OpenLabTools/Microscope/Docs/Presentation Images/3D Printing 2.JPG

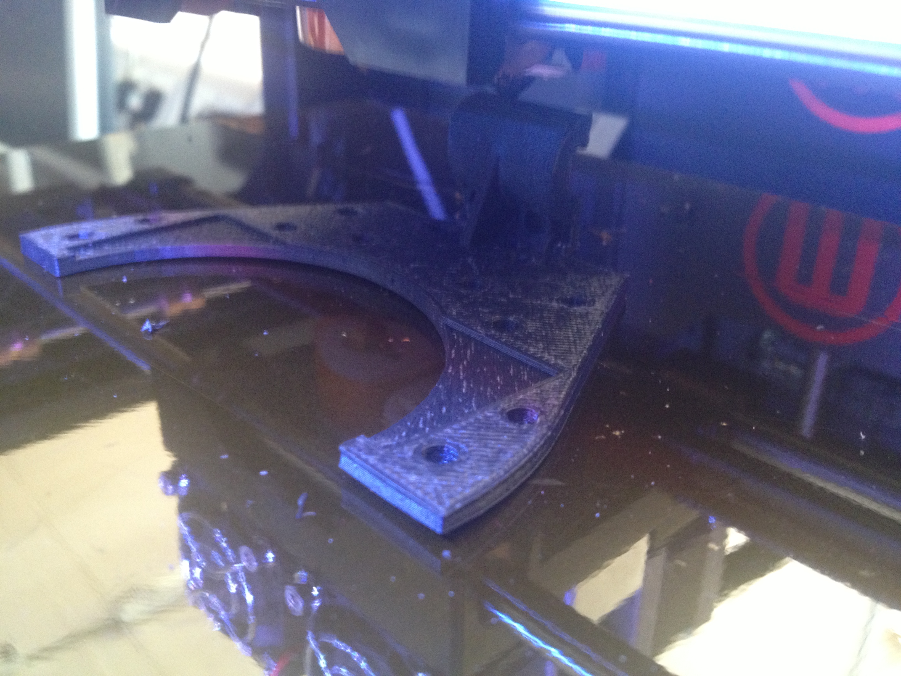
Docs/Presentation Images/3D Printing 2.JPG
