OpenLabTools/Microscope/Docs/Presentation Images/3D Printing 1.JPG

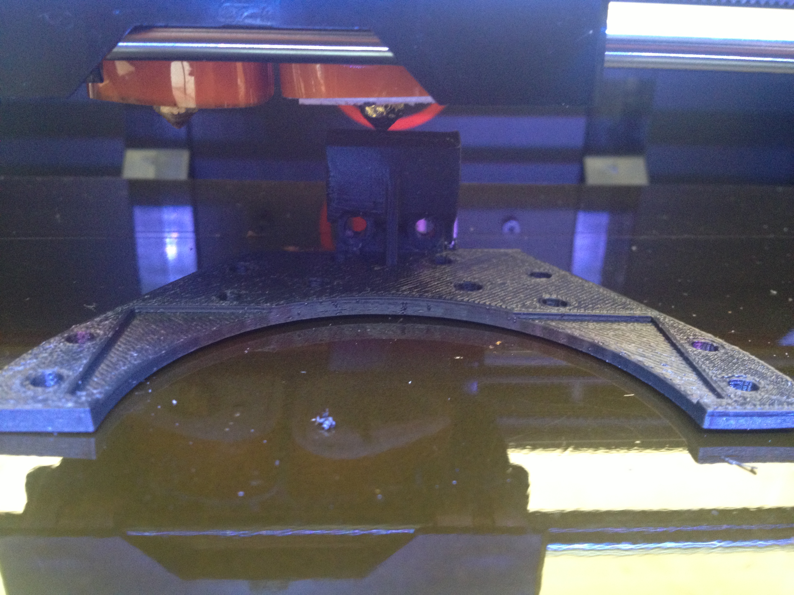
Docs/Presentation Images/3D Printing 1.JPG
