OpenLabTools/Microscope/README.md

Microscope
==========

OpenLabTools Microscope Project
