OpenLabTools/Microscope/CAD/README.md

CAD
===

This folder contains the CAD files for the microscope.
