OpenLabTools/Microscope/Raspberry Pi/CPP/README.md

Raspberry Pi
============

This file contains the Raspberry Pi-side code for the microscope.
