OpenLabTools/Microscope/Docs/chromaticabberation.jpg

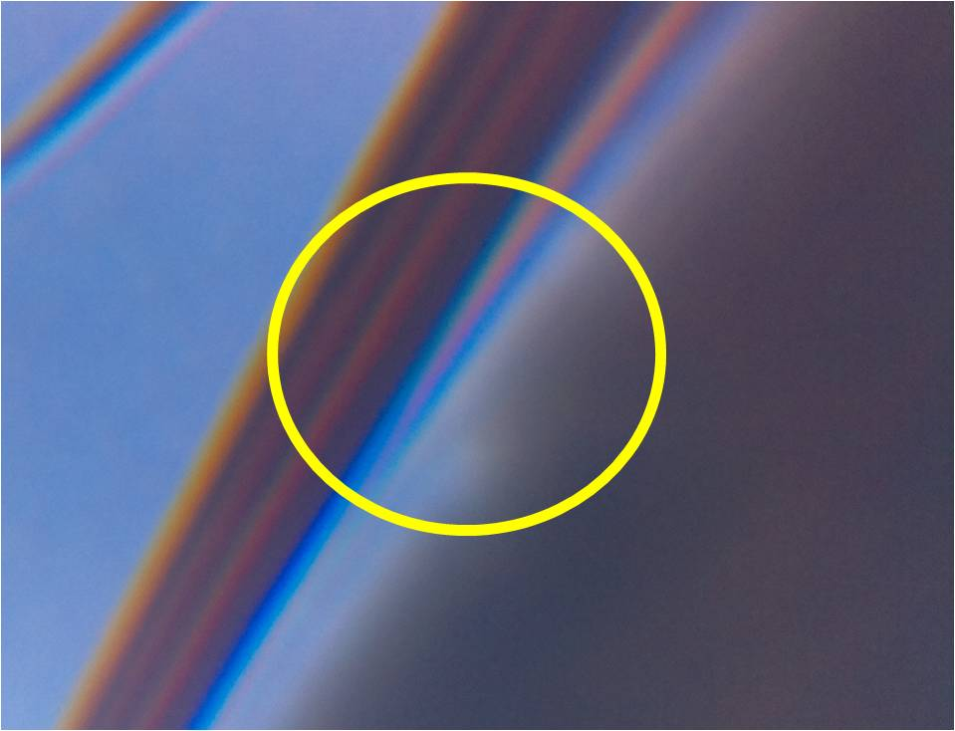
Docs/chromaticabberation.jpg
