OpenLabTools/Microscope/Docs/Focus.jpg

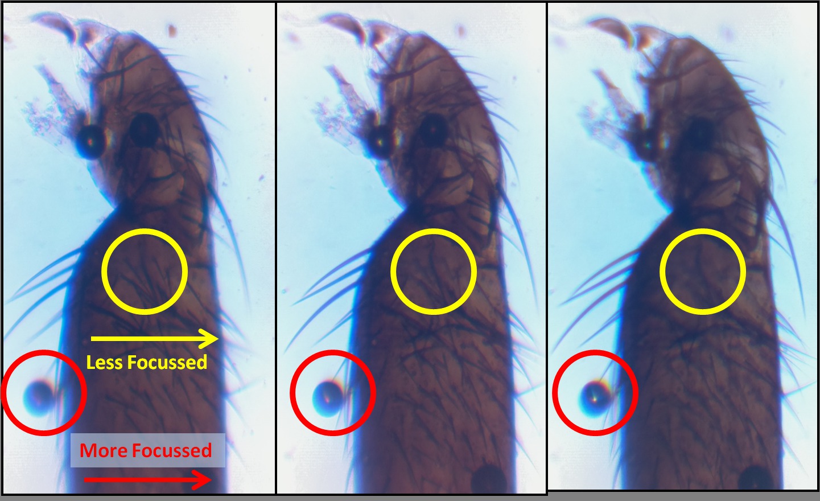
Docs/Focus.jpg
