OpenLabTools/Microscope/Docs/Image Placeholder.jpg

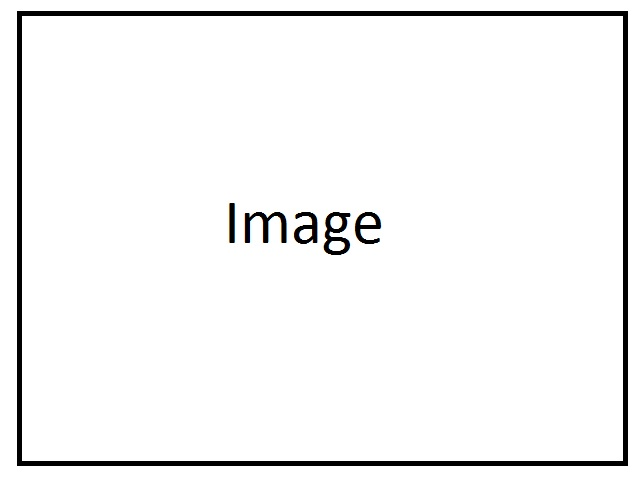
Docs/Image Placeholder.jpg
