OpenLabTools/Microscope/Docs/optical_tube_bolts.jpg

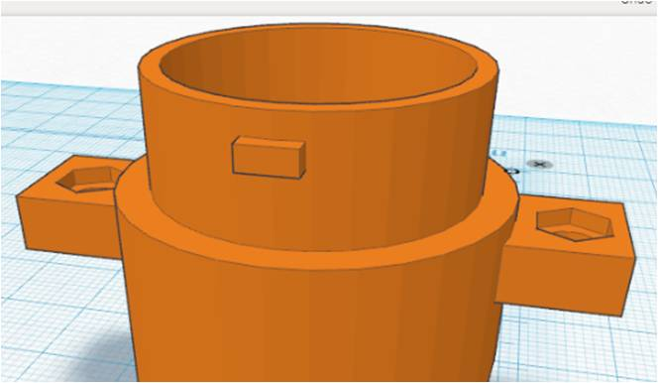
Docs/optical_tube_bolts.jpg
