OpenLabTools/Microscope/Docs/optical_tube_pins.jpg

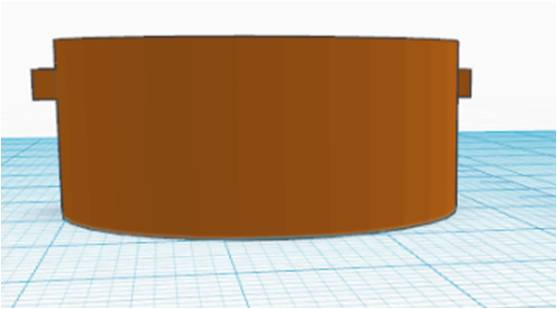
Docs/optical_tube_pins.jpg
