OpenLabTools/Microscope/Docs/Optics Diagram.jpg

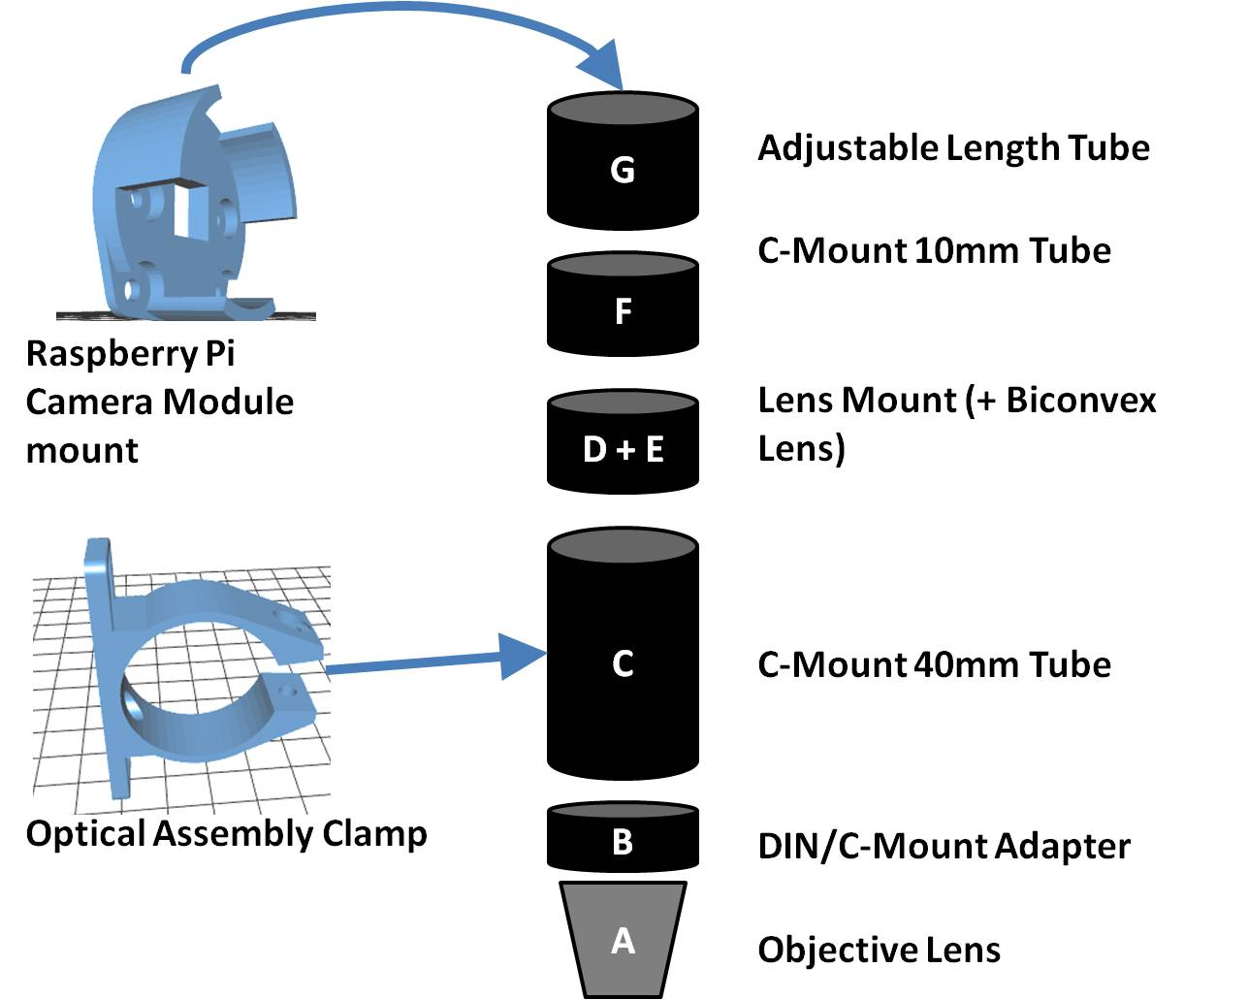
Docs/Optics Diagram.jpg
