OpenLabTools/Microscope/Docs/planoconvex.jpg

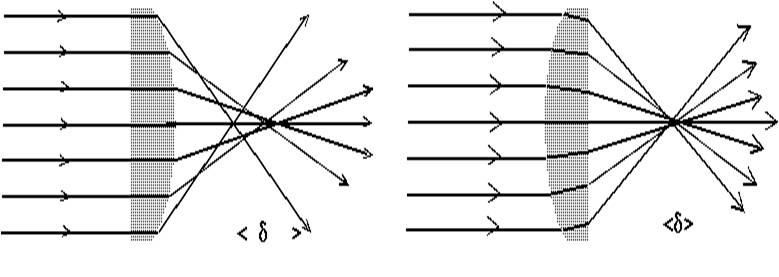
Docs/planoconvex.jpg
