OpenLabTools/Microscope/Docs/Presentation Images/Cell Count 1.png

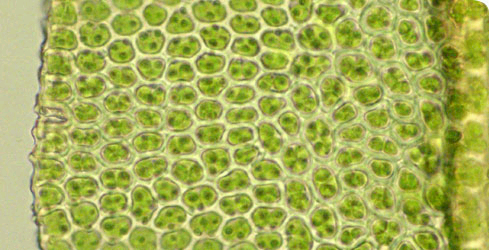
Docs/Presentation Images/Cell Count 1.png
