OpenLabTools/Microscope/Docs/Presentation Images/Cell Count 3 - Threshold.png

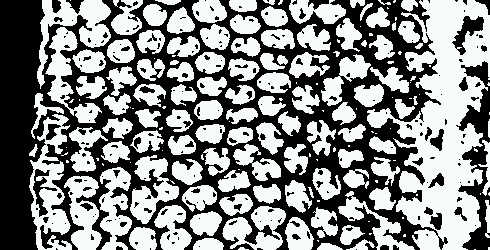
Docs/Presentation Images/Cell Count 3 - Threshold.png
