OpenLabTools/Microscope/Docs/Presentation Images/Cell Count 4 - Erode.png

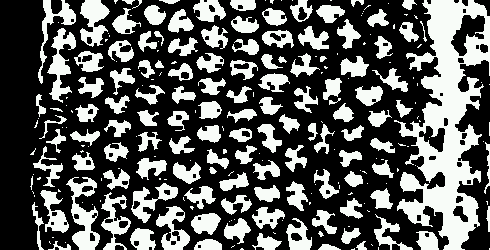
Docs/Presentation Images/Cell Count 4 - Erode.png
