OpenLabTools/Microscope/Docs/Presentation Images/Cell Count 6 - Blob Dectection.png

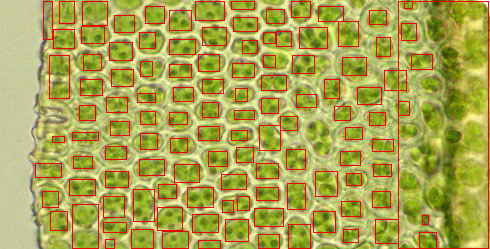
Docs/Presentation Images/Cell Count 6 - Blob Dectection.png
