OpenLabTools/Microscope/Docs/Presentation Images/Lead-screw.JPG

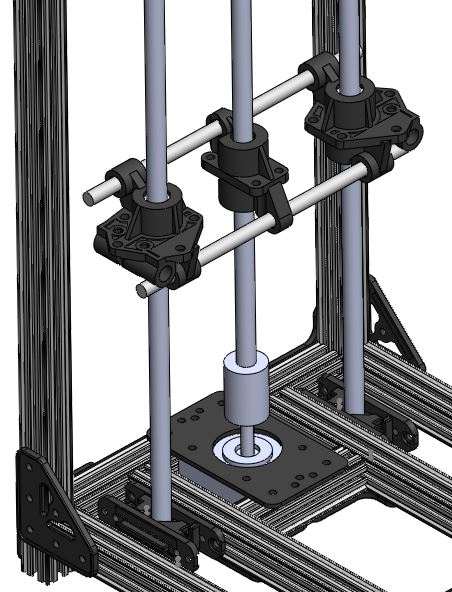
Docs/Presentation Images/Lead-screw.JPG
