OpenLabTools/Microscope/Docs/Presentation Images/Microscope Compact.JPG

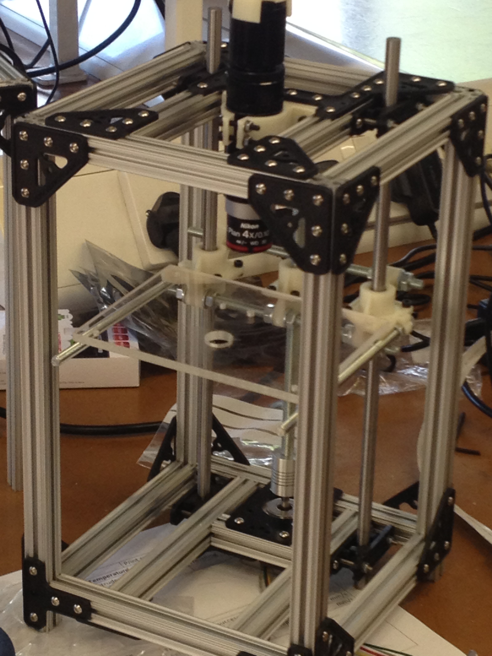
Docs/Presentation Images/Microscope Compact.JPG
