OpenLabTools/Microscope/Docs/Presentation Images/Microscope Structure.JPG

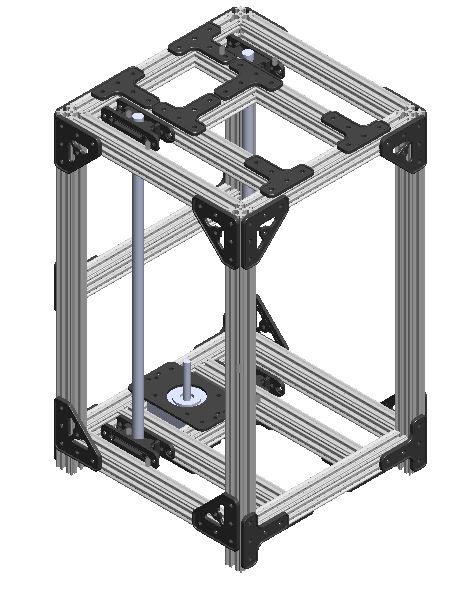
Docs/Presentation Images/Microscope Structure.JPG
