OpenLabTools/Microscope/Docs/Presentation Images/OpenBeams.JPG

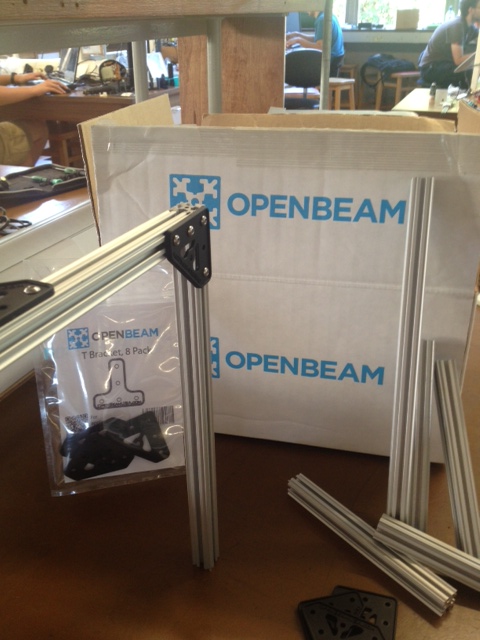
Docs/Presentation Images/OpenBeams.JPG
