OpenLabTools/Microscope/Docs/Presentation Images/X-Y Stage CAD.JPG

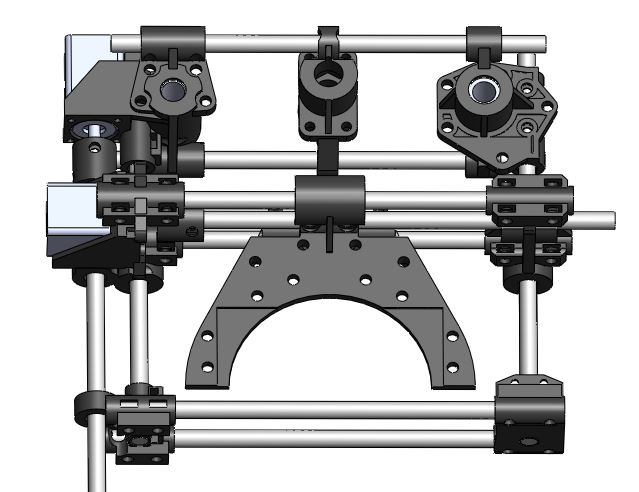
Docs/Presentation Images/X-Y Stage CAD.JPG
