OpenLabTools/Microscope/Docs/Presentation Images/X-Y Stage Front Elevation.JPG

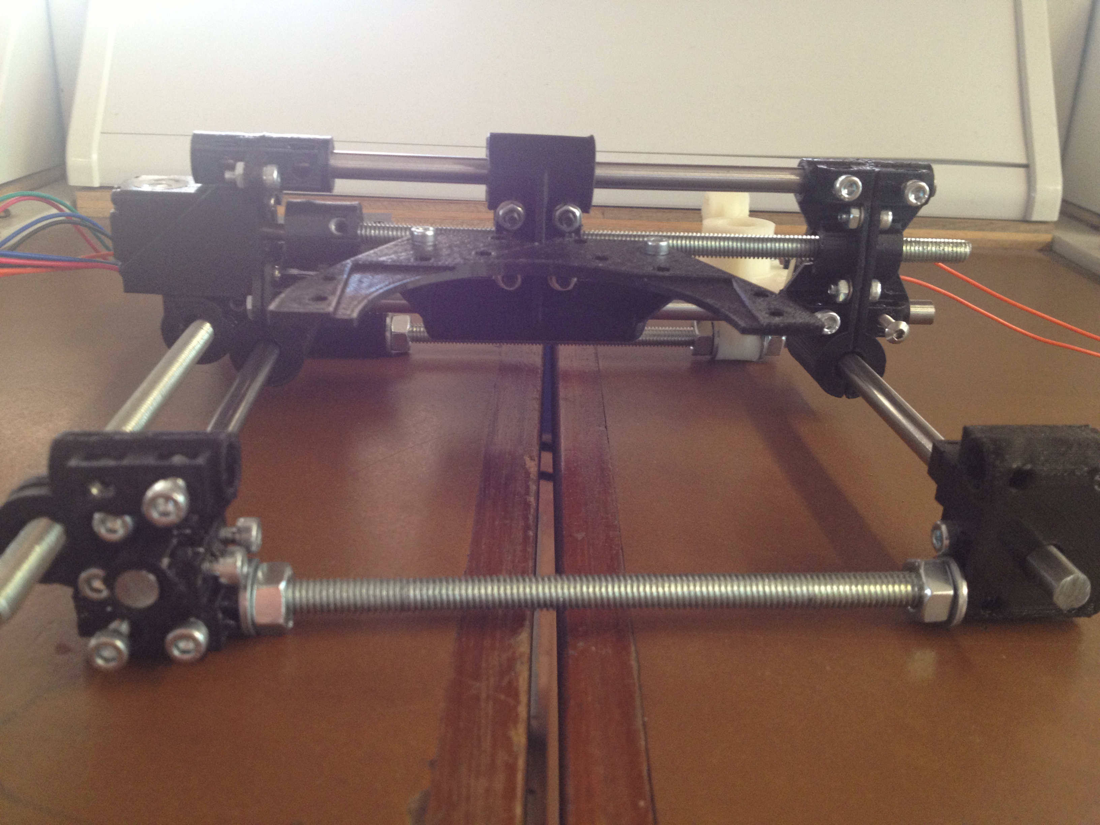
Docs/Presentation Images/X-Y Stage Front Elevation.JPG
