OpenLabTools/Microscope/Docs/Presentation Images/X-Y Stage Top Elevation.JPG

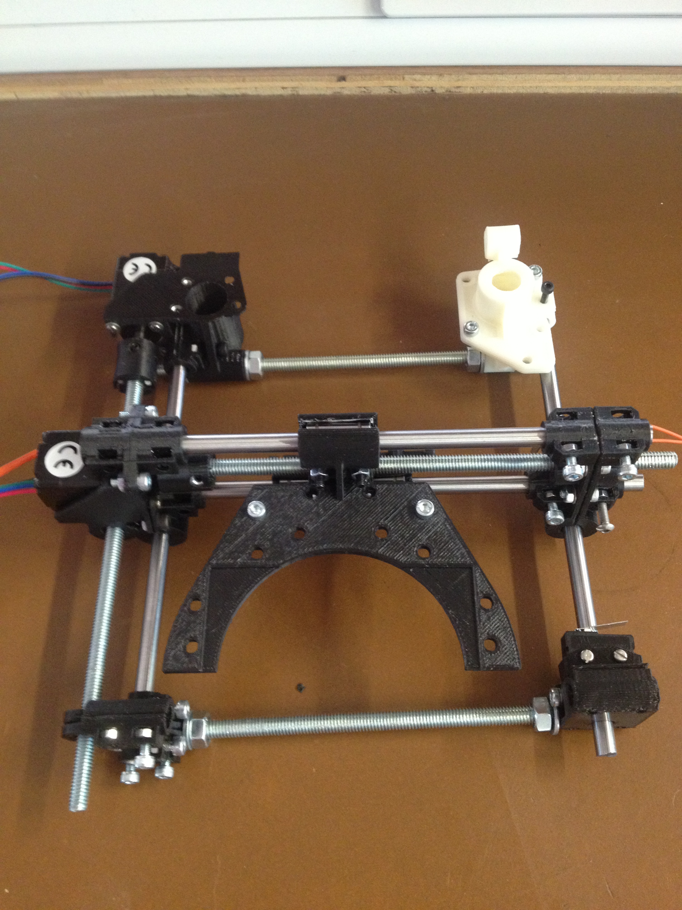
Docs/Presentation Images/X-Y Stage Top Elevation.JPG
