OpenLabTools/Microscope/Docs/tube40fly.jpg

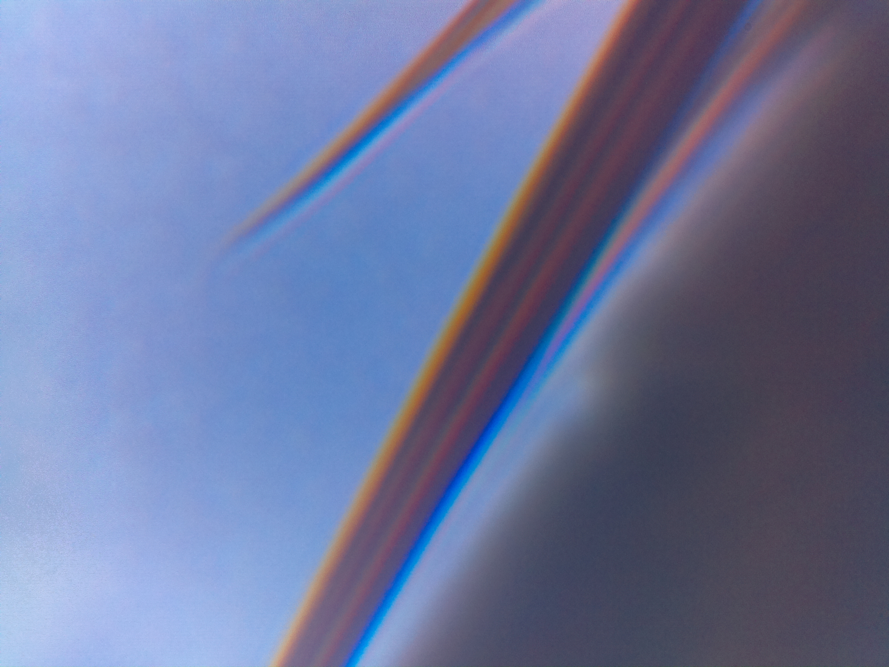
Docs/tube40fly.jpg
