OpenLabTools/Microscope/CAD/Solidworks/Assembly All.SLDASM

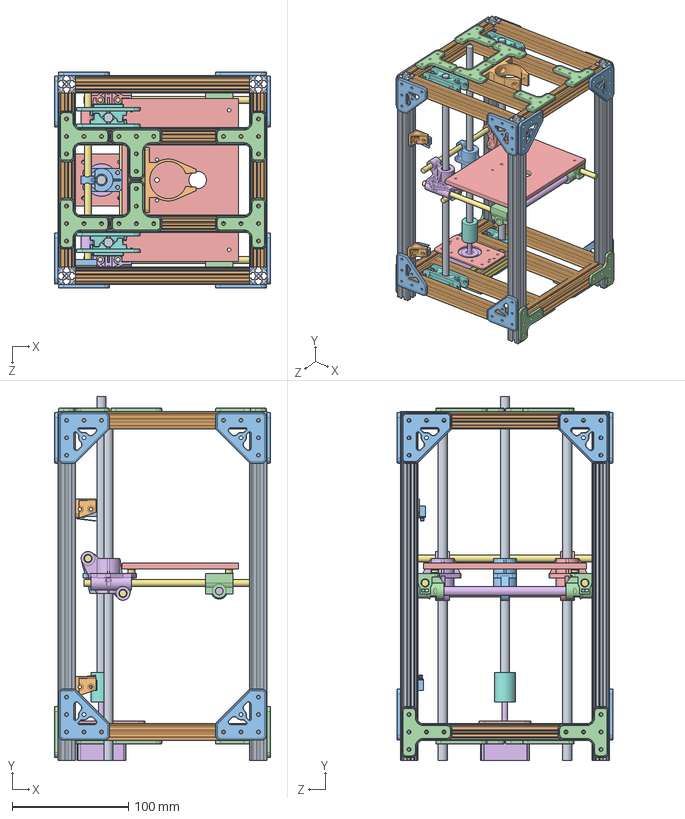
[picture p22: CAD file, 2016-01-19]
CAD/Solidworks/Assembly All.SLDASM
186.0 x 313.0 x 186.0 mm
OpenBeam Al 300mm x 4
OpenBeam Al 150mm x 12
OpenBeam L Plate x 12
OpenBeam T Plate x 16
OpenBeam Stepper Motor Mount
Stepper Motor NEMA 17
OpenBeam Al 60mm x 2
OpenBeam Shaft Clamp x 8
8mm x 300mm Smooth Rod x 2
Thread Nut Mount Crossbeams
LM8UU Linear Bearing x 2
Bearing Mount Left
Bearing Mount Right
6mm x 150mm Threaded Rod x 4
Flex Shaft Coupler
8mm x 250mm Rod
Endstop Mount x 2
Microswitch x 2
Front Stage Mount x 2
Stage
8mm x 120mm Threaded Rod
M3 Spacer x 4
