OpenLabTools/Microscope/CAD/Solidworks/Structure Assembly.SLDASM

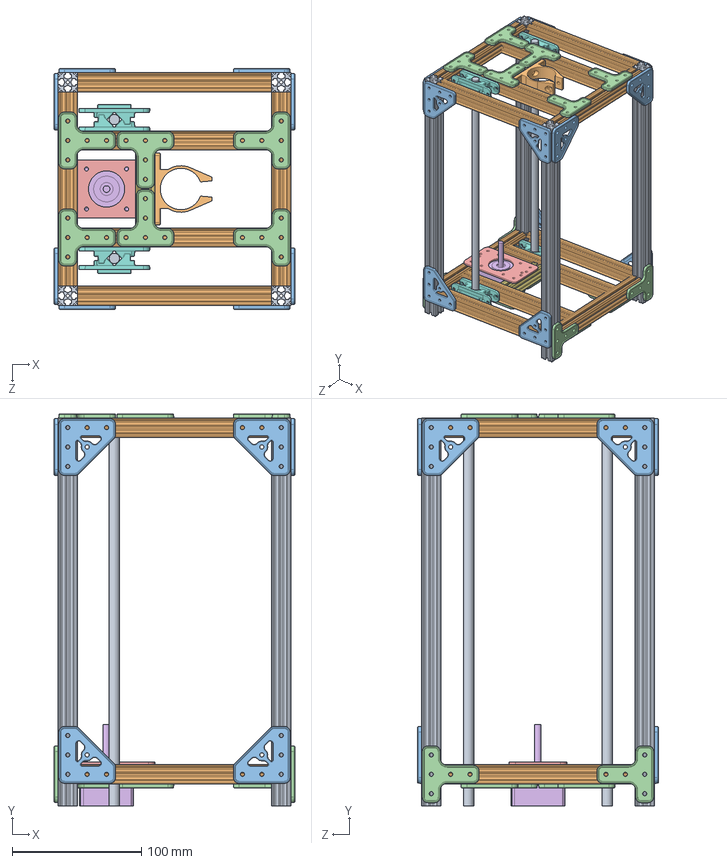
[picture p23: CAD file, 2016-01-19]
CAD/Solidworks/Structure Assembly.SLDASM
186.0 x 303.0 x 186.0 mm
OpenBeam Al 300mm x 4
OpenBeam Al 150mm x 12
OpenBeam L Plate x 12
OpenBeam T Plate x 16
OpenBeam Stepper Motor Mount
Stepper Motor NEMA 17
OpenBeam Al 60mm x 2
OpenBeam Shaft Clamp x 8
8mm x 300mm Smooth Rod x 2
