OpenLabTools/Microscope/CAD/Solidworks/XY Stage Assembly.SLDASM

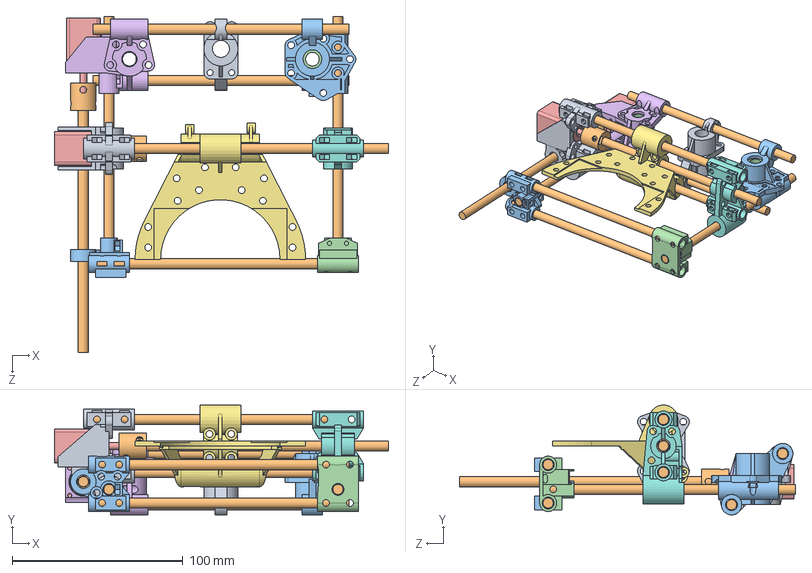
[picture p24: CAD file, 2016-01-19]
CAD/Solidworks/XY Stage Assembly.SLDASM
196.0 x 64.4 x 197.0 mm
Thread Nut Mount Crossbeams
6mm x 150mm Threaded Rod x 11
Bearing Mount Left
LM8UU Linear Bearing x 2
NEMA 8 Small Stepper Motor x 2
Bearing Mount w. Y Stepper Mount Right
X-Carriage
Y-Carriage Right w. Endstop
Y-Carriage Left w. Stepper No Pulley
Shaft Coupler 4mm-6mm x 2
Z Stage End Left
Z Stage End Right w. Endstop
