OpenLabTools/Microscope/CAD/Solidworks/Endstop Assembly.SLDASM

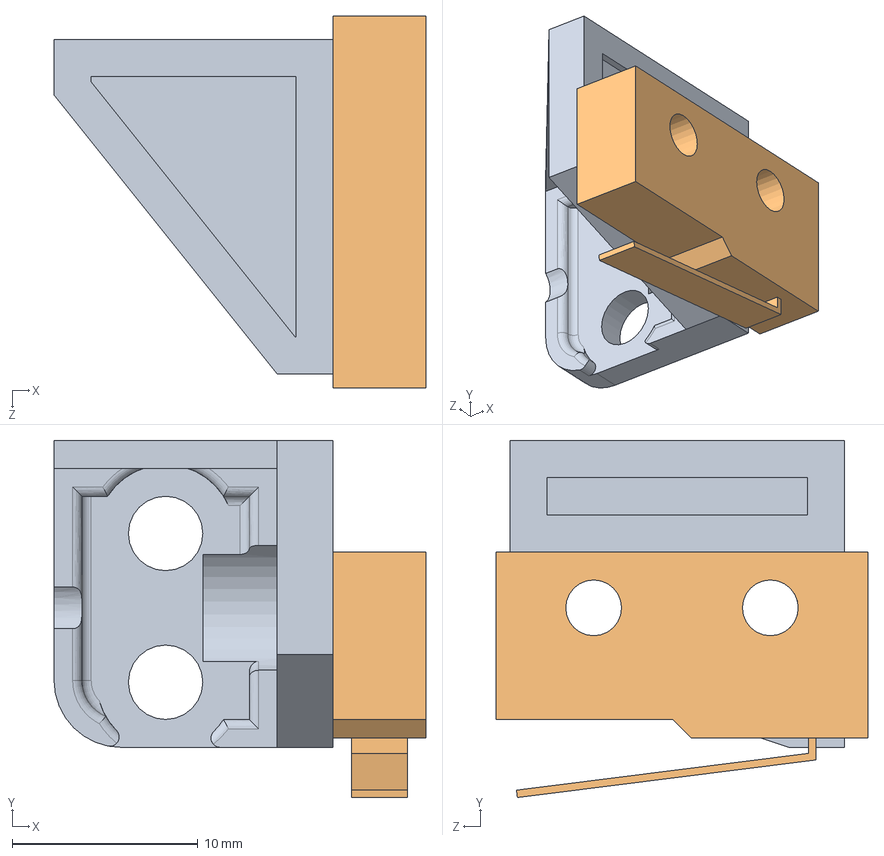
[picture p25: CAD file, 2016-01-19]
CAD/Solidworks/Endstop Assembly.SLDASM
20.0 x 19.2 x 20.0 mm
Endstop Mount
Microswitch
