OpenLabTools/Microscope/CAD/Solidworks/Support Assembly.SLDASM

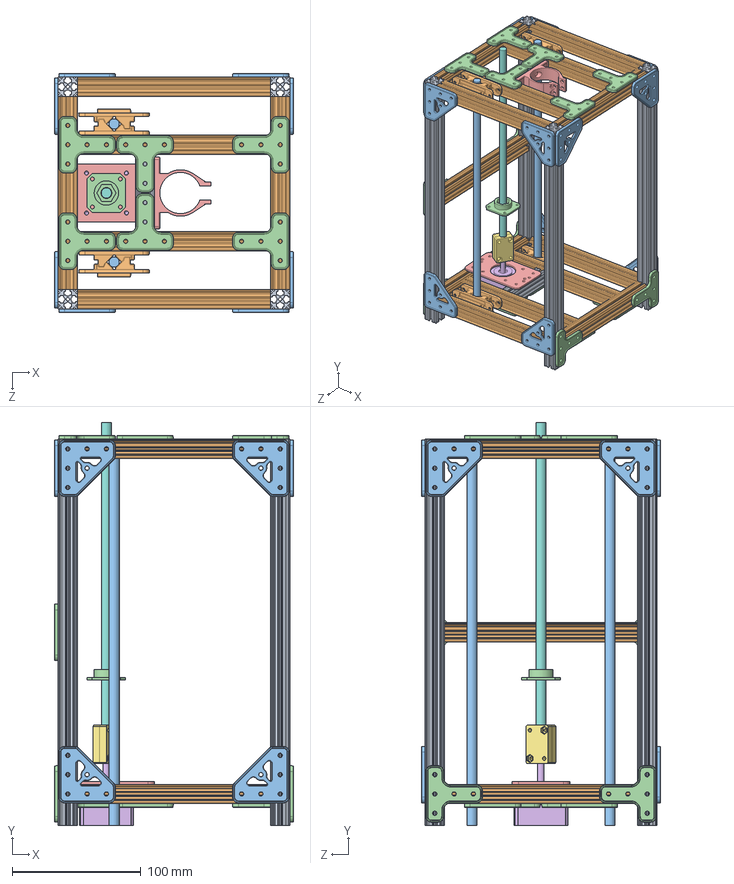
[picture p26: CAD file, 2016-01-19]
CAD/Solidworks/Support Assembly.SLDASM
186.0 x 313.0 x 186.0 mm
OpenBeam Al 300mm x 4
OpenBeam Al 150mm x 13
OpenBeam L Plate x 12
OpenBeam T Plate x 18
OpenBeam Stepper Motor Mount
Stepper Motor NEMA 17
Shaft Coupler x 2
8mm x 250mm Rod
OpenBeam Al 60mm x 2
OpenBeam Shaft Clamp x 8
8mm x 300mm Smooth Rod x 2
Optics Clamp
