OpenLabTools/Microscope/CAD/Optical Components CAD/corner_connector.stl

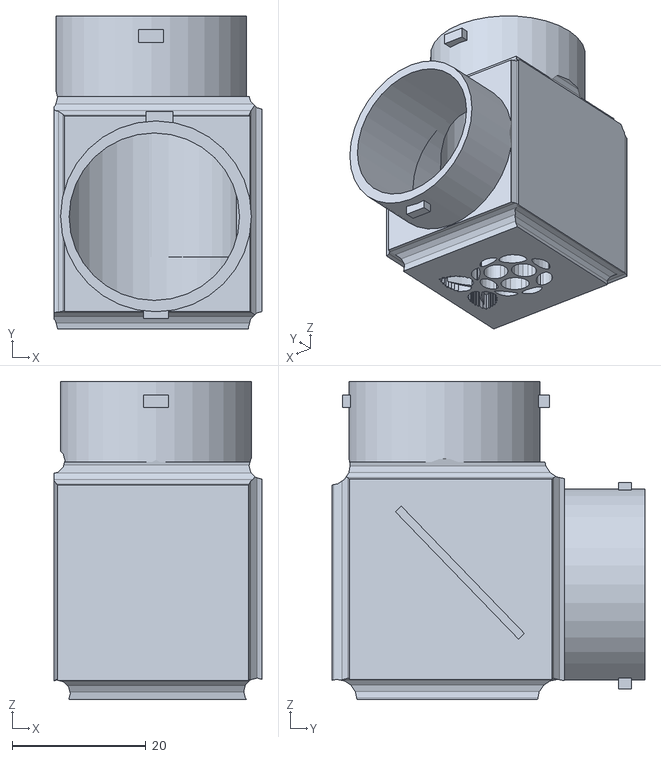
[picture p27: CAD file, 2013-08-21]
CAD/Optical Components CAD/corner_connector.stl
31.0 x 46.7 x 47.5
