OpenLabTools/Microscope/CAD/Optics Clamp.STL

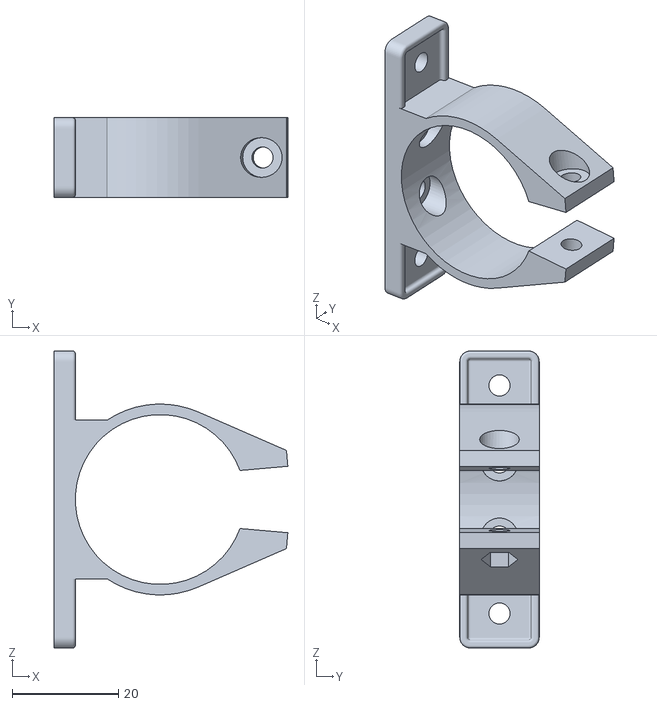
[picture p28: CAD file, 2013-08-07]
CAD/Optics Clamp.STL
44.1 x 15.0 x 56.0
