OpenLabTools/Microscope/CAD/Optical Components CAD/male-male_connector.stl

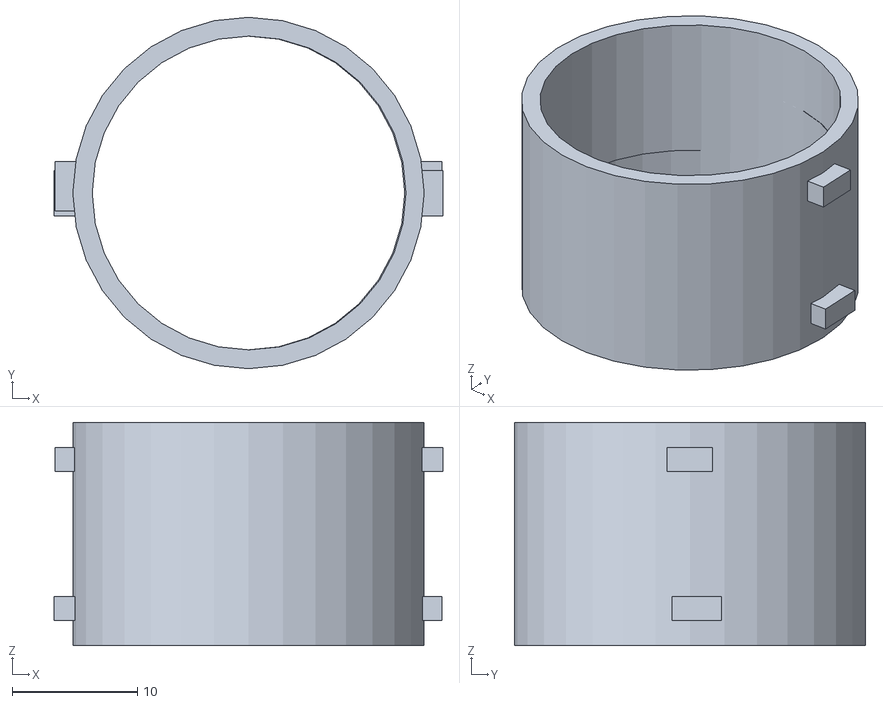
[picture p29: CAD file, 2013-08-21]
CAD/Optical Components CAD/male-male_connector.stl
31.0 x 28.0 x 17.8
