OpenLabTools/Microscope/CAD/Solidworks/Slide Clamp Body.SLDPRT

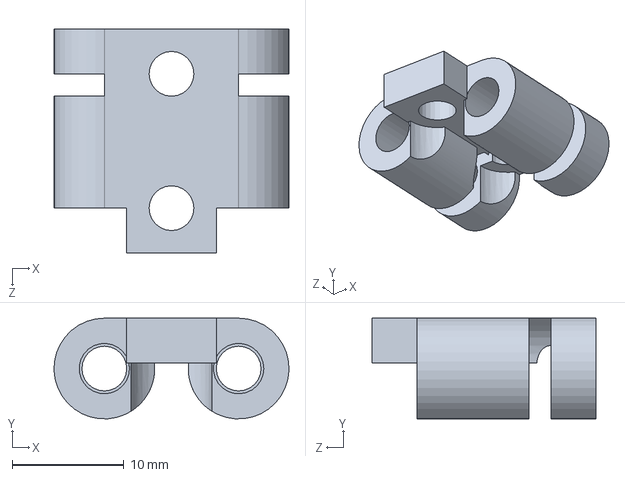
[picture p30: CAD file, 2016-01-19]
CAD/Solidworks/Slide Clamp Body.SLDPRT
21.0 x 8.99 x 20.0 mm
