OpenLabTools/Microscope/CAD/Optical Components CAD/objective_lens_mount.stl

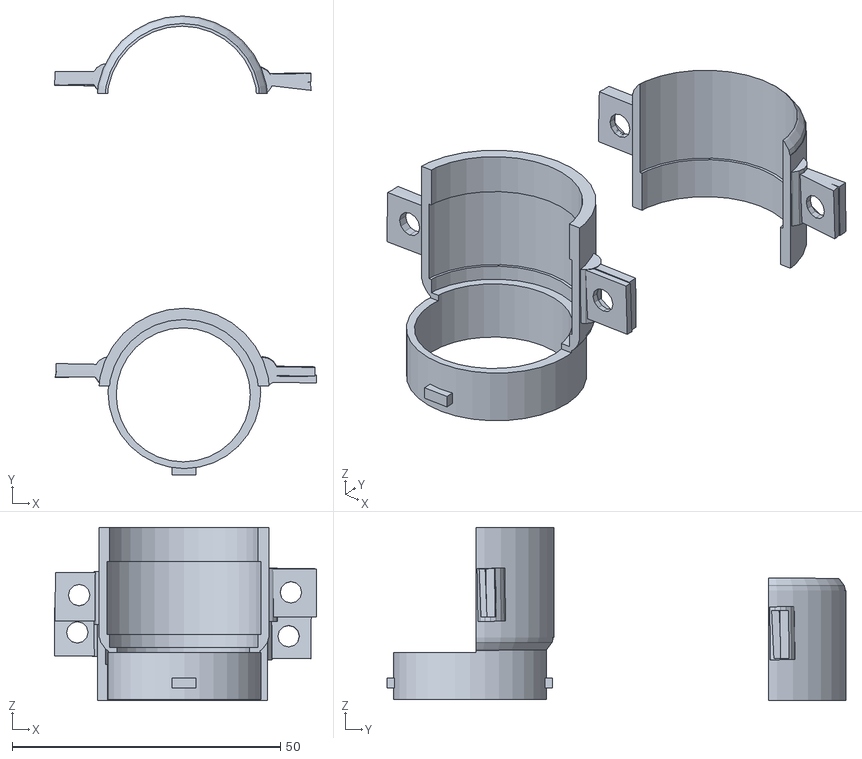
[picture p31: CAD file, 2013-08-21]
CAD/Optical Components CAD/objective_lens_mount.stl
48.9 x 85.6 x 32.3
