OpenLabTools/Microscope/CAD/Optical Components CAD/lighting_mount.stl

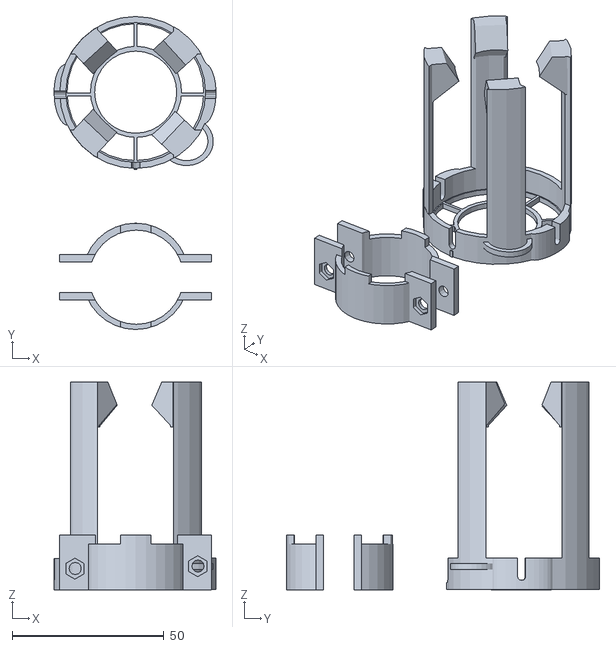
[picture p32: CAD file, 2013-08-21]
CAD/Optical Components CAD/lighting_mount.stl
53.3 x 103.0 x 68.3
