OpenLabTools/Microscope/CAD/Solidworks/Small Stepper Mount.SLDPRT

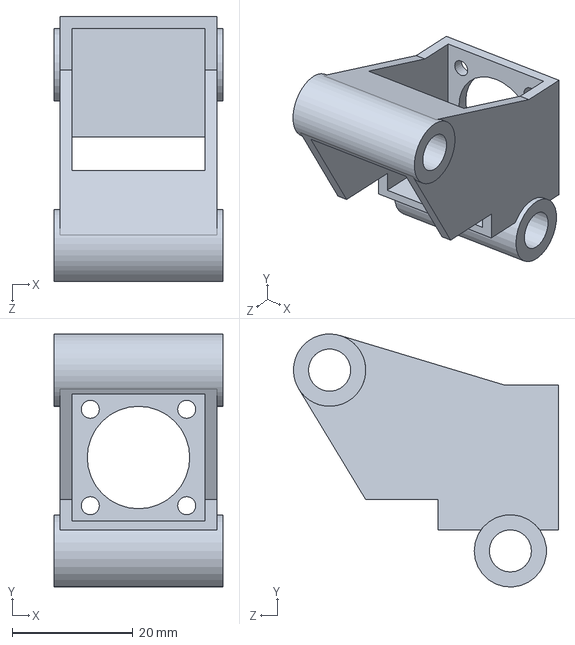
[picture p33: CAD file, 2016-01-19]
CAD/Solidworks/Small Stepper Mount.SLDPRT
28.0 x 42.0 x 44.0 mm
