OpenLabTools/Microscope/CAD/Optical Components CAD/25mm_lens_mount.stl

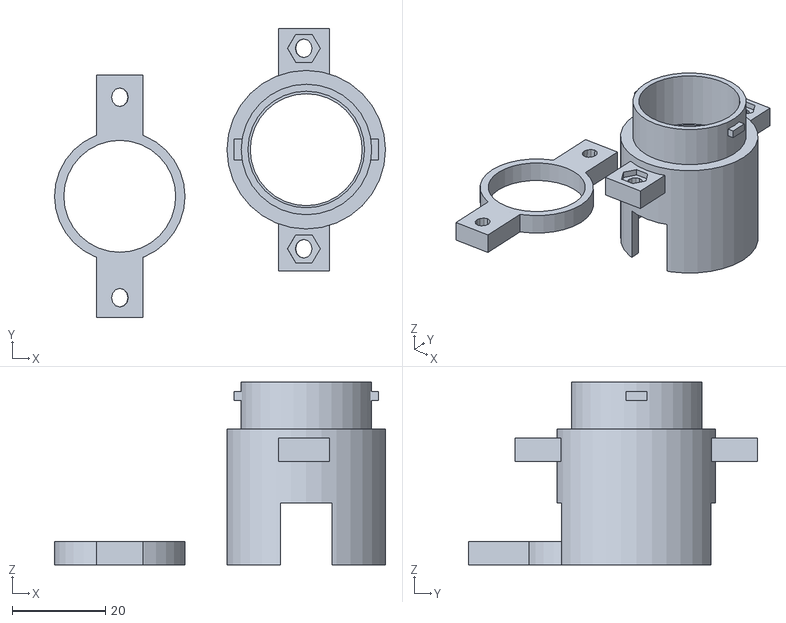
[picture p34: CAD file, 2013-08-21]
CAD/Optical Components CAD/25mm_lens_mount.stl
71.0 x 62.0 x 39.2
