OpenLabTools/Microscope/CAD/Solidworks/Linear Bearing Mount.SLDPRT

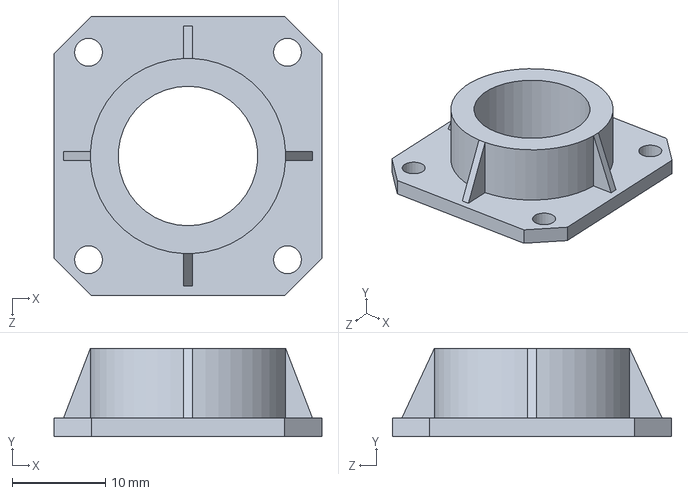
[picture p35: CAD file, 2016-01-19]
CAD/Solidworks/Linear Bearing Mount.SLDPRT
28.8 x 9.50 x 30.0 mm
