OpenLabTools/Microscope/CAD/Optical Components CAD/adjustable_length_tube.stl

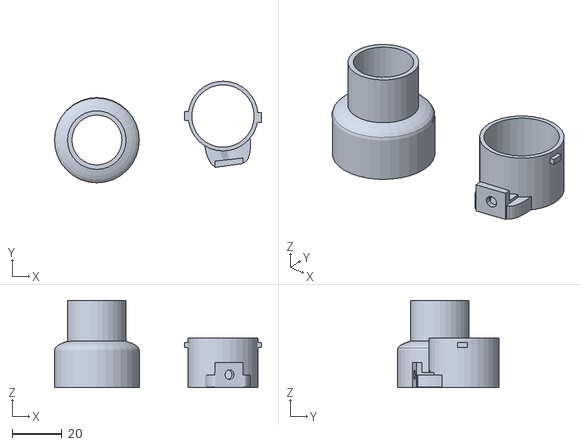
[picture p36: CAD file, 2013-08-21]
CAD/Optical Components CAD/adjustable_length_tube.stl
83.0 x 40.8 x 35.0
