OpenLabTools/Microscope/CAD/Optical Components CAD/female-female_connector.stl

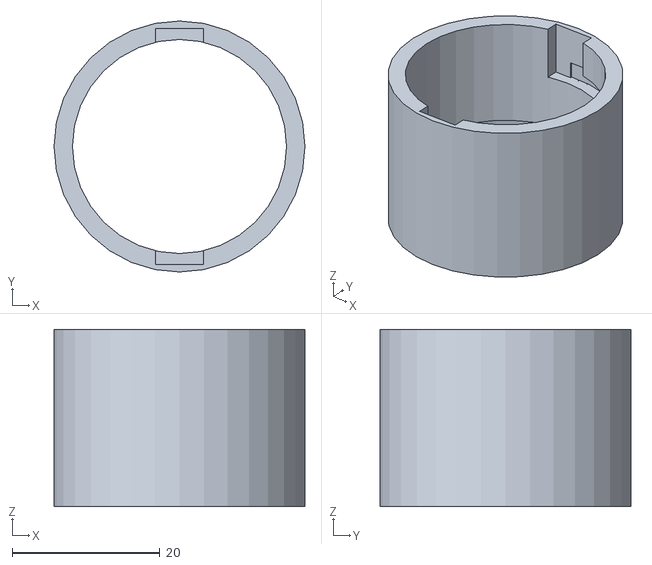
[picture p37: CAD file, 2013-08-21]
CAD/Optical Components CAD/female-female_connector.stl
34.0 x 34.0 x 24.0
