OpenLabTools/Microscope/CAD/Solidworks/Y-Carriage Left w. Stepper No Pulley.SLDPRT

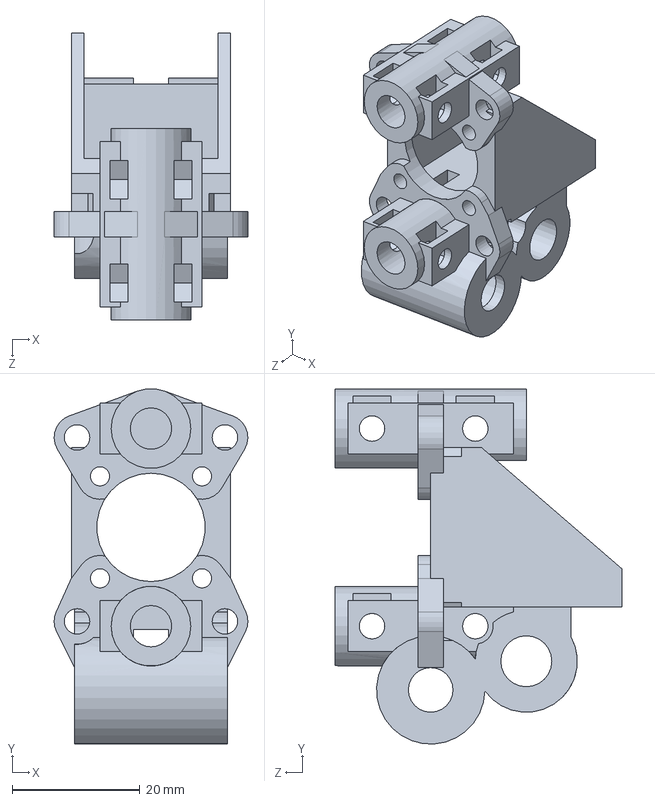
[picture p38: CAD file, 2016-01-19]
CAD/Solidworks/Y-Carriage Left w. Stepper No Pulley.SLDPRT
30.4 x 55.7 x 45.0 mm
