OpenLabTools/Microscope/CAD/Solidworks/Microswitch.SLDPRT

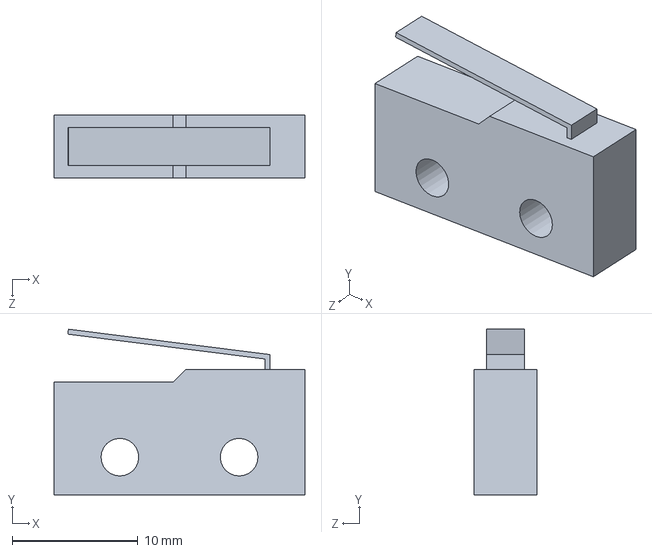
[picture p39: CAD file, 2016-01-19]
CAD/Solidworks/Microswitch.SLDPRT
20.0 x 13.2 x 5.00 mm
