OpenLabTools/Microscope/CAD/Solidworks/Endstop Mount.SLDPRT

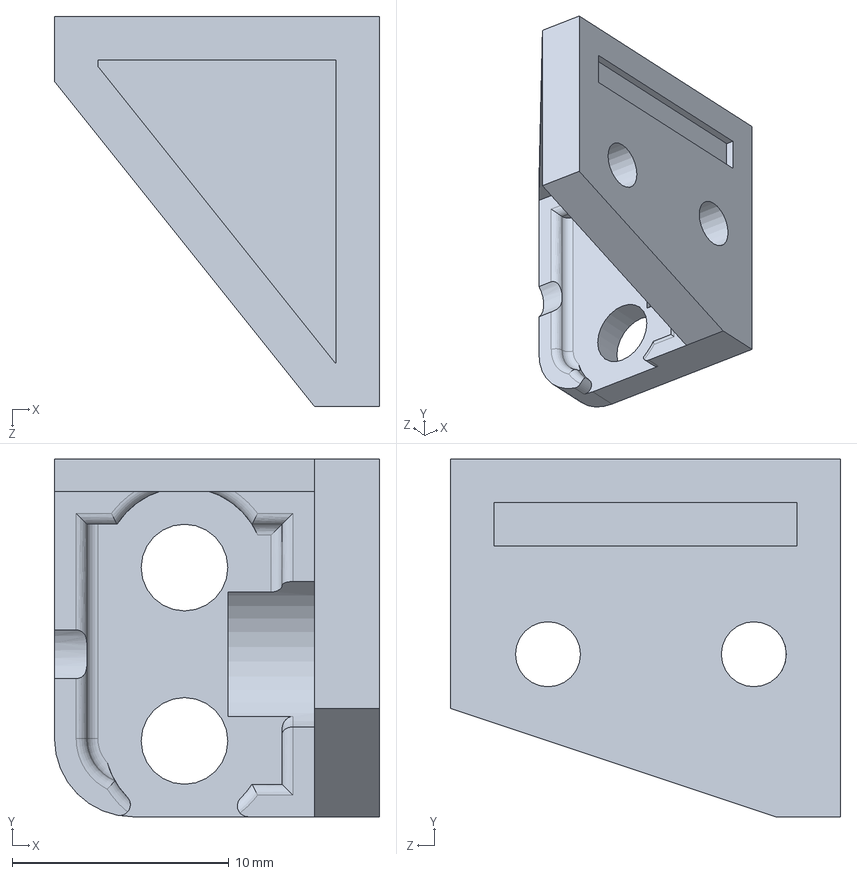
[picture p40: CAD file, 2016-01-19]
CAD/Solidworks/Endstop Mount.SLDPRT
15.0 x 16.5 x 18.0 mm
