OpenLabTools/Microscope/CAD/Solidworks/Optics Tube 40mm.SLDPRT

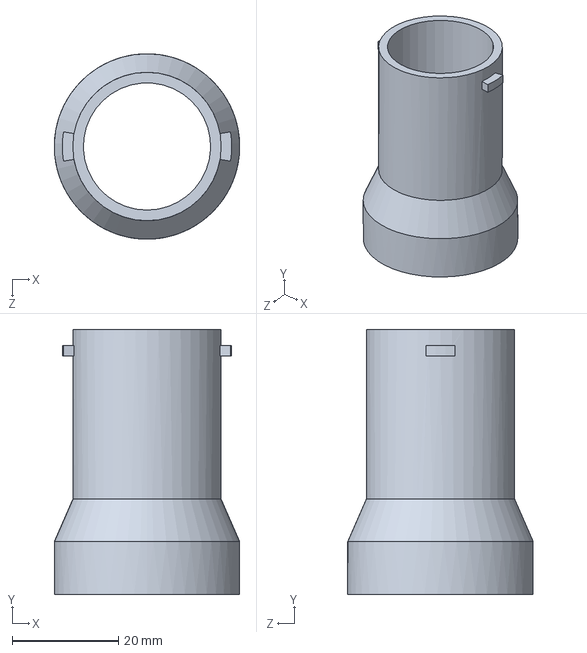
[picture p42: CAD file, 2016-01-19]
CAD/Solidworks/Optics Tube 40mm.SLDPRT
35.0 x 50.0 x 35.0 mm
