OpenLabTools/Microscope/CAD/Solidworks/Bearing Mount Left Top.SLDPRT

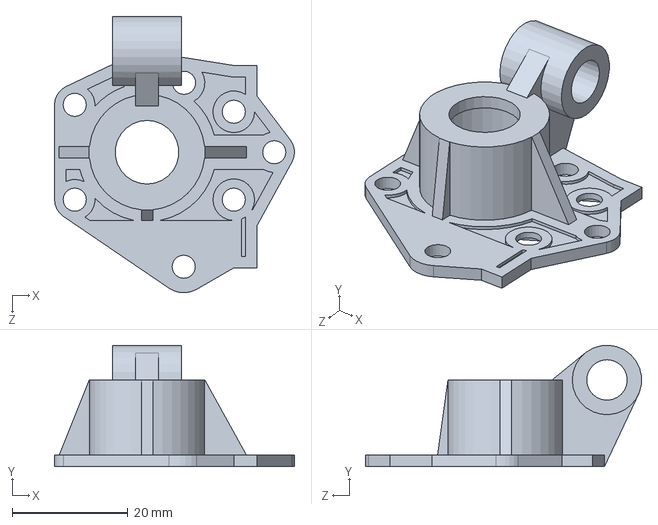
[picture p43: CAD file, 2016-01-19]
CAD/Solidworks/Bearing Mount Left Top.SLDPRT
41.5 x 21.0 x 47.8 mm
