OpenLabTools/Microscope/CAD/Solidworks/Optics Tube 50mm.SLDPRT

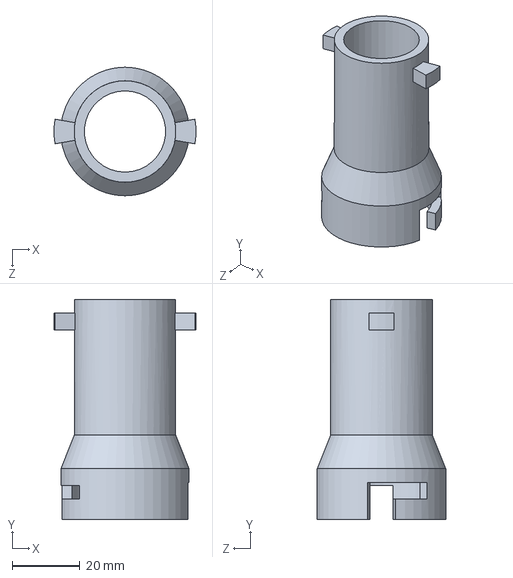
[picture p44: CAD file, 2016-01-19]
CAD/Solidworks/Optics Tube 50mm.SLDPRT
41.9 x 65.0 x 38.0 mm
