OpenLabTools/Microscope/CAD/Solidworks/8mm x 300mm Smooth Rod.SLDPRT

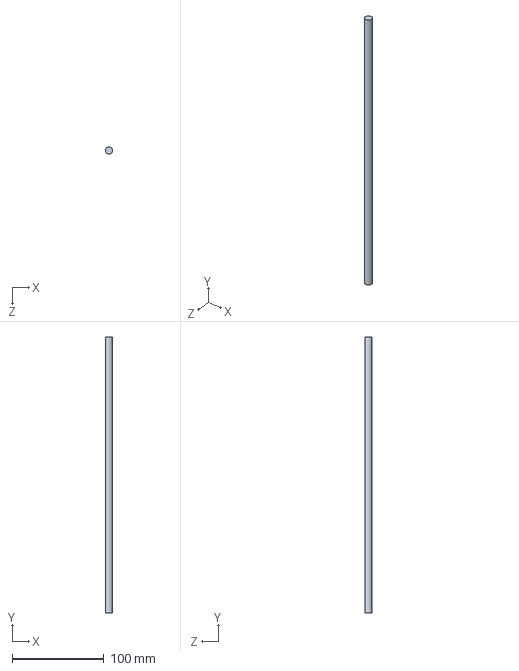
[picture p45: CAD file, 2016-01-19]
CAD/Solidworks/8mm x 300mm Smooth Rod.SLDPRT
8.00 x 300.0 x 8.00 mm
