OpenLabTools/Microscope/CAD/Solidworks/M3 Spacer.SLDPRT

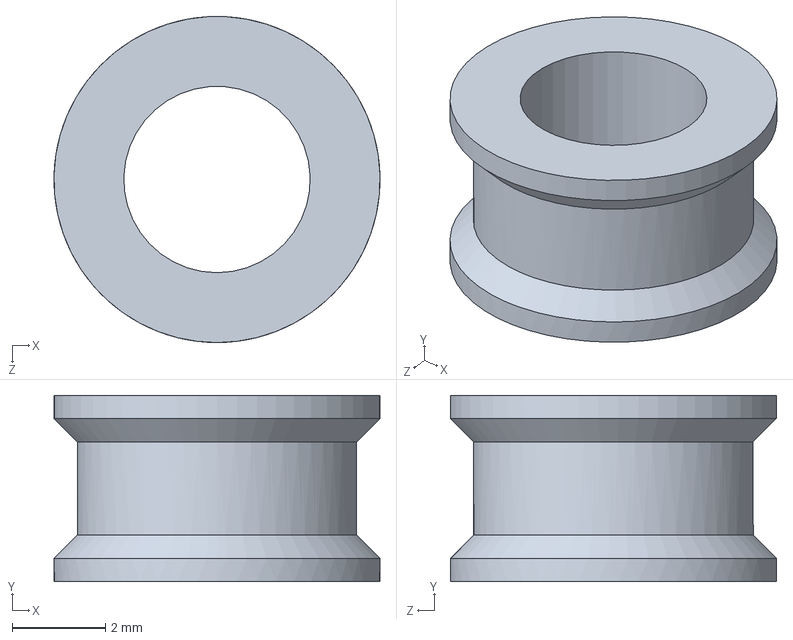
[picture p46: CAD file, 2016-01-19]
CAD/Solidworks/M3 Spacer.SLDPRT
7.00 x 4.00 x 7.00 mm
