OpenLabTools/Microscope/CAD/Solidworks/6mm x 150mm Threaded Rod.SLDPRT

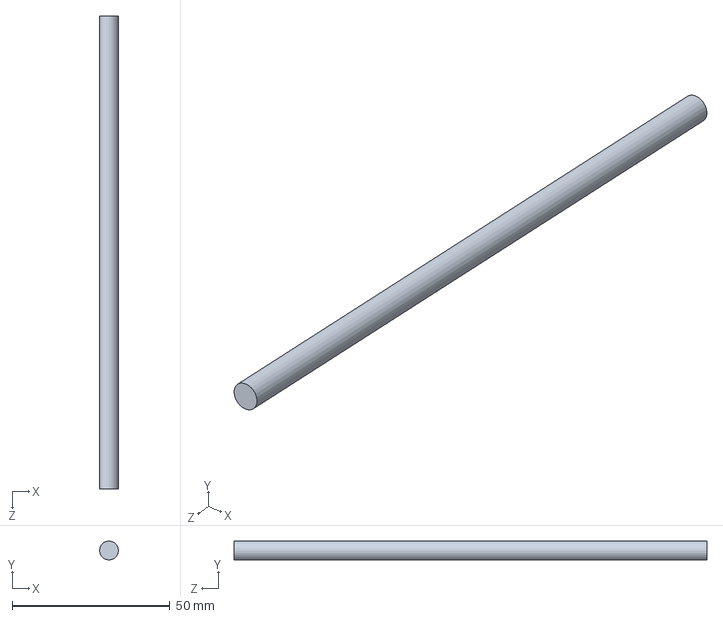
[picture p47: CAD file, 2016-01-19]
CAD/Solidworks/6mm x 150mm Threaded Rod.SLDPRT
6.00 x 6.00 x 150.0 mm
