OpenLabTools/Microscope/CAD/Solidworks/8mm x 250mm Rod.SLDPRT

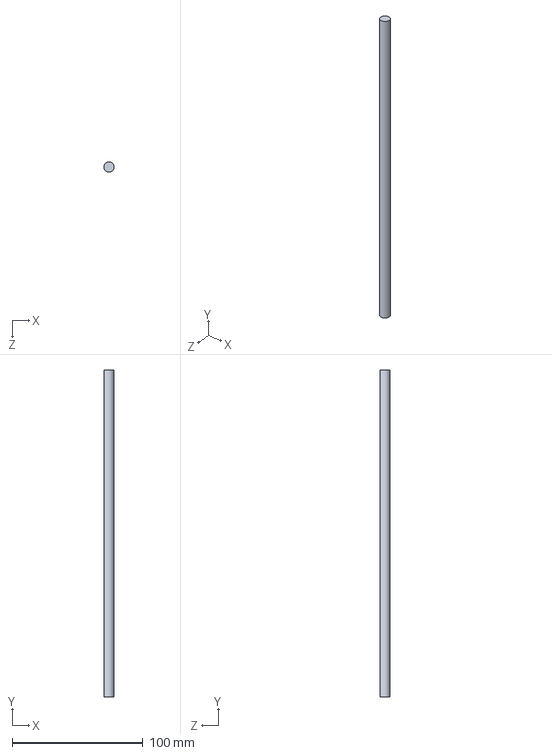
[picture p48: CAD file, 2016-01-19]
CAD/Solidworks/8mm x 250mm Rod.SLDPRT
8.00 x 250.0 x 8.00 mm
