OpenLabTools/Microscope/CAD/Solidworks/Bearing Mount w. Y Stepper Mount Right.SLDPRT

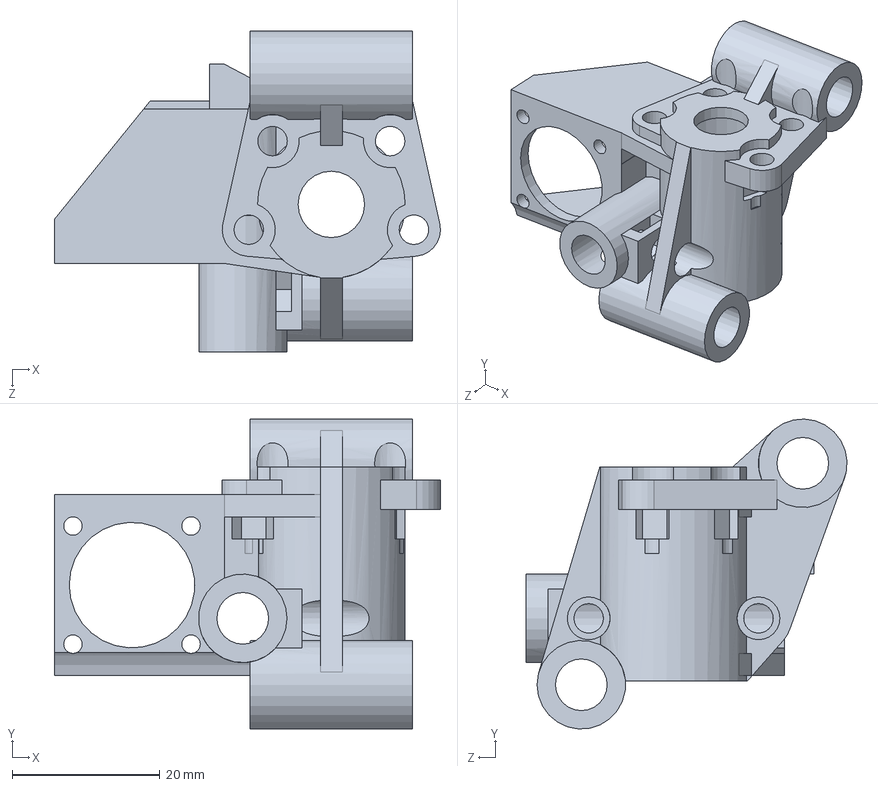
[picture p49: CAD file, 2016-01-19]
CAD/Solidworks/Bearing Mount w. Y Stepper Mount Right.SLDPRT
52.3 x 42.0 x 43.5 mm
