OpenLabTools/Microscope/CAD/Solidworks/LM8UU Linear Bearing.SLDPRT

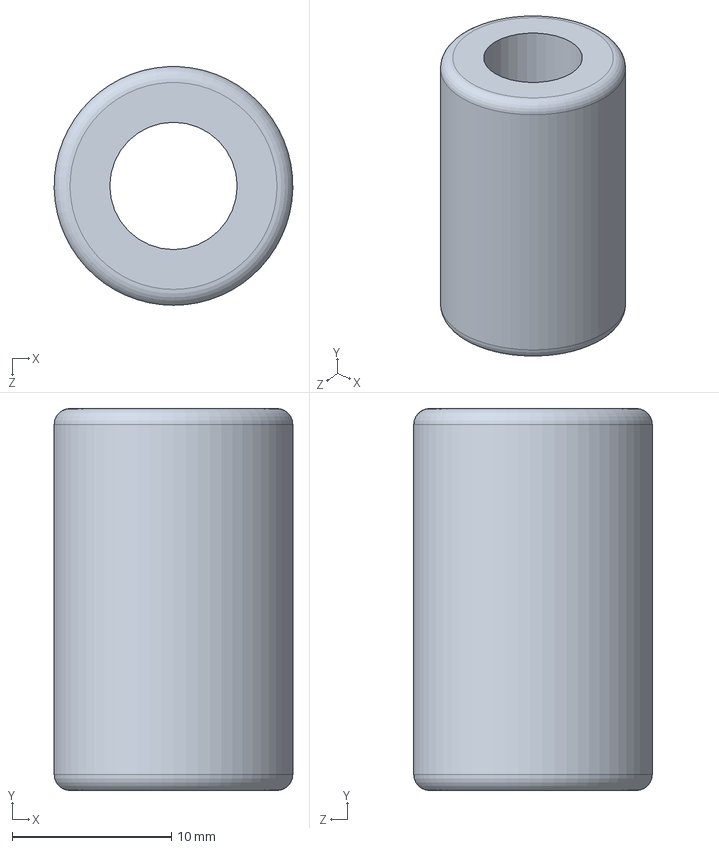
[picture p50: CAD file, 2016-01-19]
CAD/Solidworks/LM8UU Linear Bearing.SLDPRT
15.0 x 24.0 x 15.0 mm
