OpenLabTools/Microscope/CAD/Solidworks/Pi Camera Mount.SLDPRT

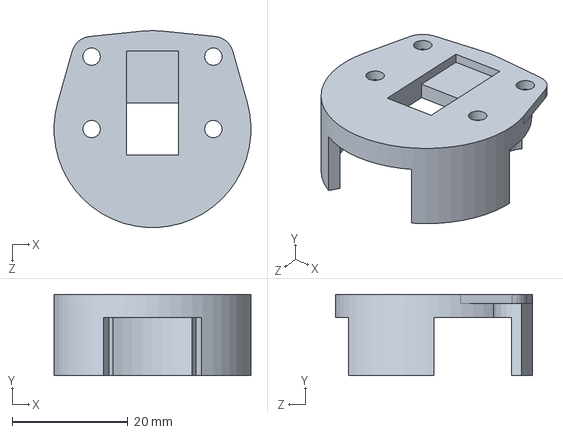
[picture p51: CAD file, 2016-01-19]
CAD/Solidworks/Pi Camera Mount.SLDPRT
34.0 x 14.0 x 34.0 mm
