OpenLabTools/Microscope/CAD/Solidworks/Stage Protector.SLDPRT

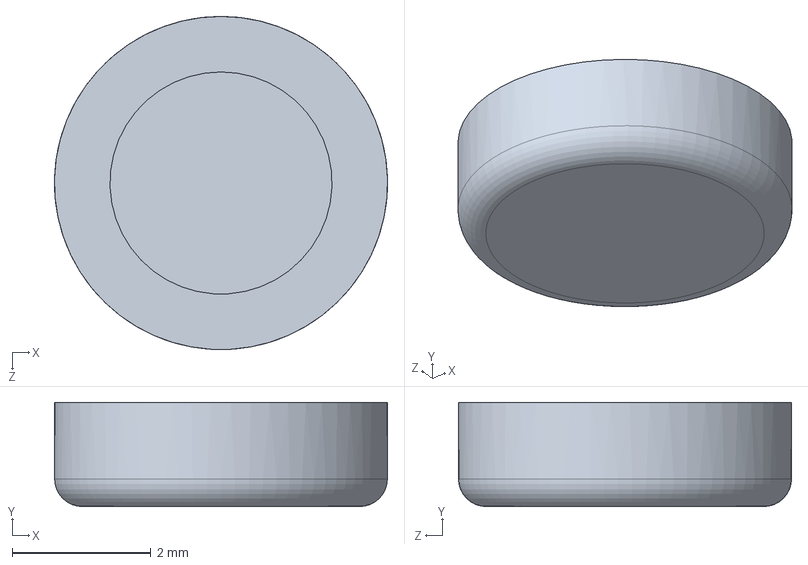
[picture p52: CAD file, 2016-01-19]
CAD/Solidworks/Stage Protector.SLDPRT
4.80 x 1.50 x 4.80 mm
