OpenLabTools/Microscope/CAD/Solidworks/Front Stage Mount.SLDPRT

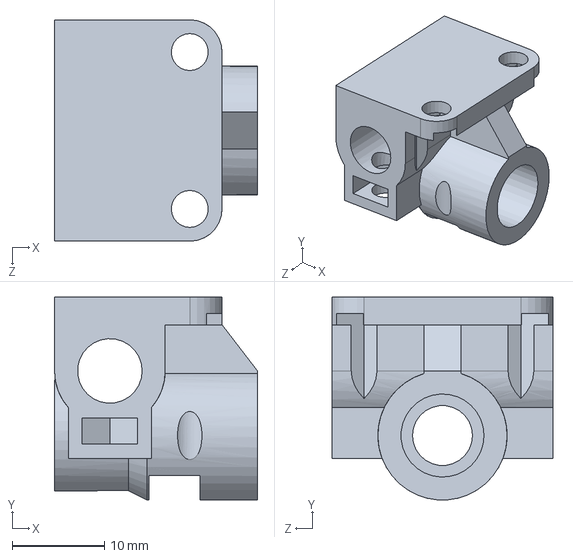
[picture p53: CAD file, 2016-01-19]
CAD/Solidworks/Front Stage Mount.SLDPRT
22.0 x 22.0 x 24.0 mm
