OpenLabTools/Microscope/CAD/Solidworks/Stage.SLDPRT

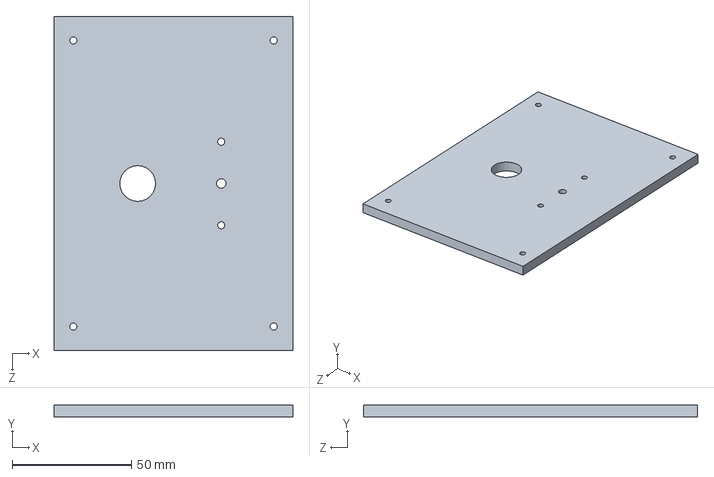
[picture p54: CAD file, 2016-01-19]
CAD/Solidworks/Stage.SLDPRT
100.0 x 5.00 x 140.0 mm
