OpenLabTools/Microscope/CAD/Solidworks/Bearing Mount Right.SLDPRT

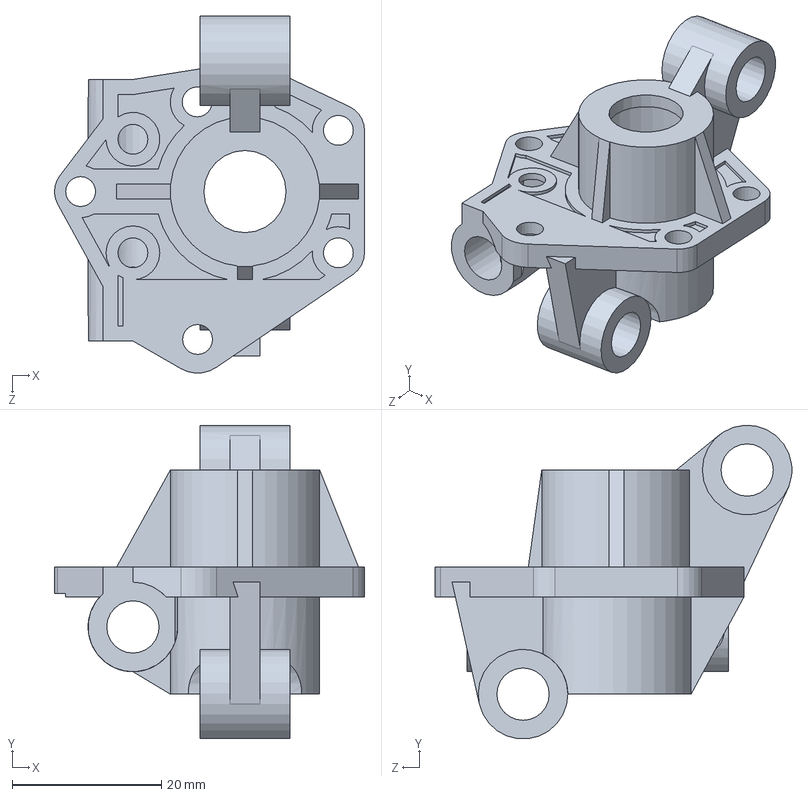
[picture p55: CAD file, 2016-01-19]
CAD/Solidworks/Bearing Mount Right.SLDPRT
41.5 x 42.0 x 47.8 mm
