OpenLabTools/Microscope/CAD/Solidworks/Lighting Mount.SLDPRT

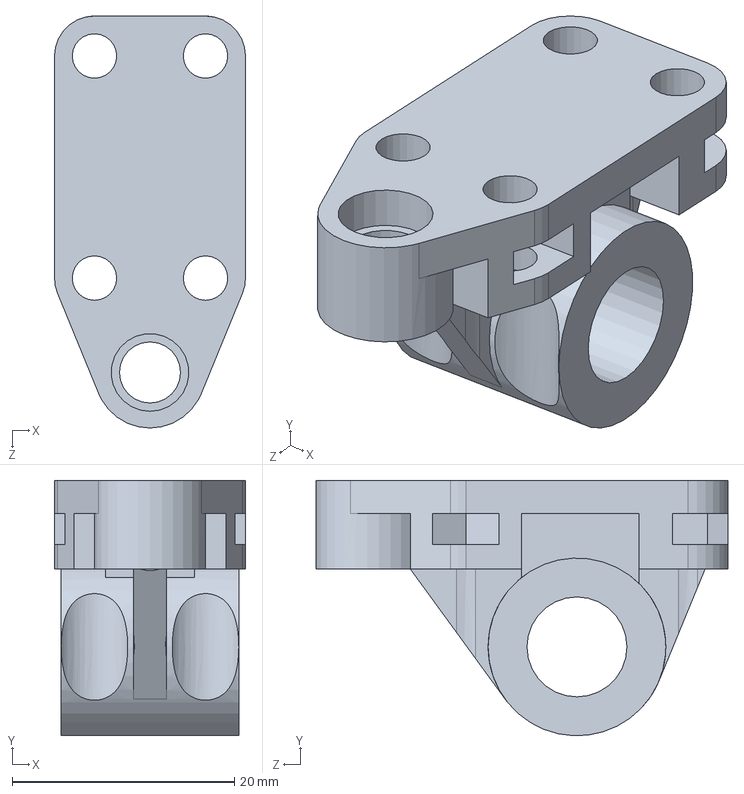
[picture p56: CAD file, 2016-01-19]
CAD/Solidworks/Lighting Mount.SLDPRT
17.2 x 23.0 x 37.1 mm
