OpenLabTools/Microscope/CAD/Solidworks/Optics Tube 20mm.SLDPRT

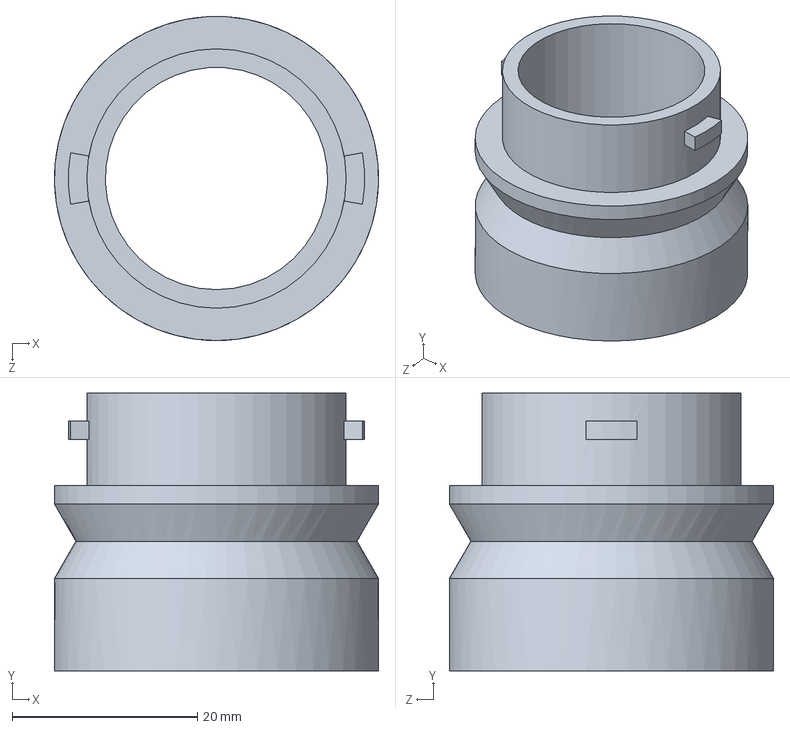
[picture p57: CAD file, 2016-01-19]
CAD/Solidworks/Optics Tube 20mm.SLDPRT
35.0 x 30.0 x 35.0 mm
