OpenLabTools/Microscope/CAD/Solidworks/Sample Clamp Flat.SLDPRT

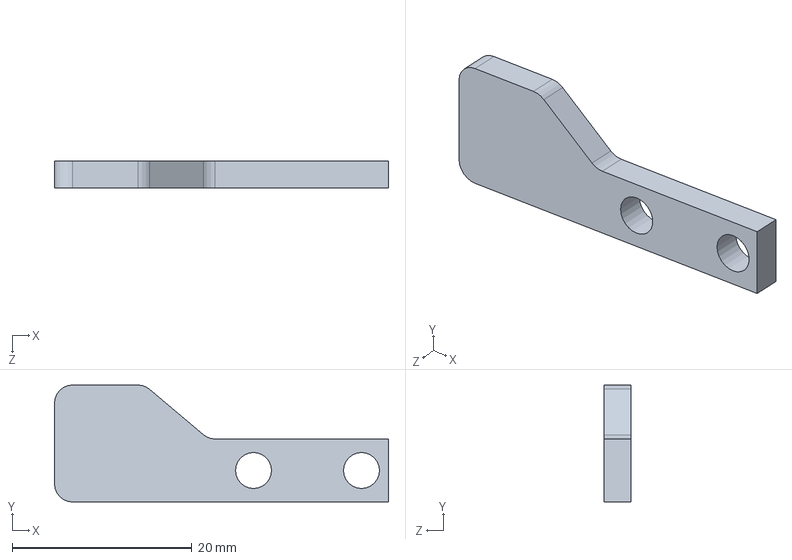
[picture p58: CAD file, 2016-01-19]
CAD/Solidworks/Sample Clamp Flat.SLDPRT
37.1 x 13.0 x 3.00 mm
