OpenLabTools/Microscope/CAD/Solidworks/Bearing Mount w. Y Stepper Mount.SLDPRT

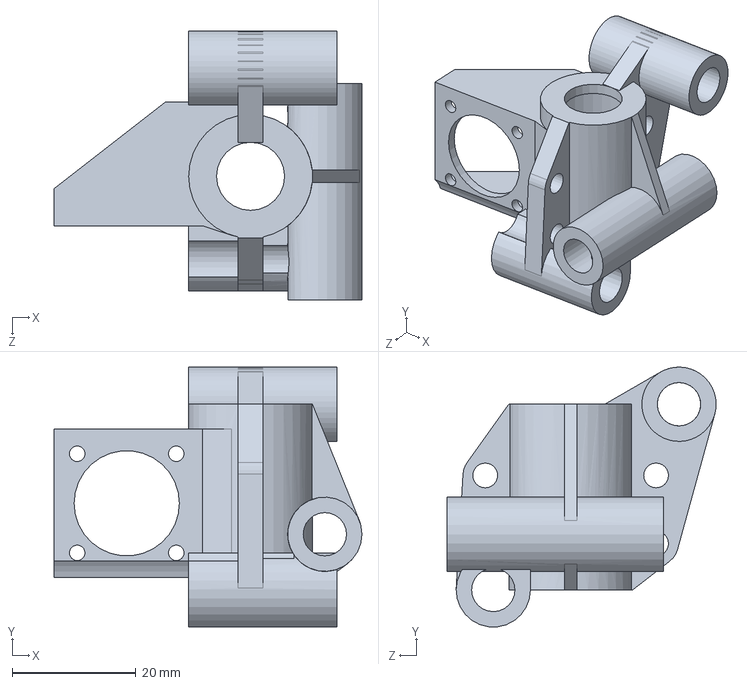
[picture p59: CAD file, 2016-01-19]
CAD/Solidworks/Bearing Mount w. Y Stepper Mount.SLDPRT
49.8 x 42.0 x 43.5 mm
