OpenLabTools/Microscope/CAD/Solidworks/Y-Carriage Left w. Stepper and Endstop.SLDPRT

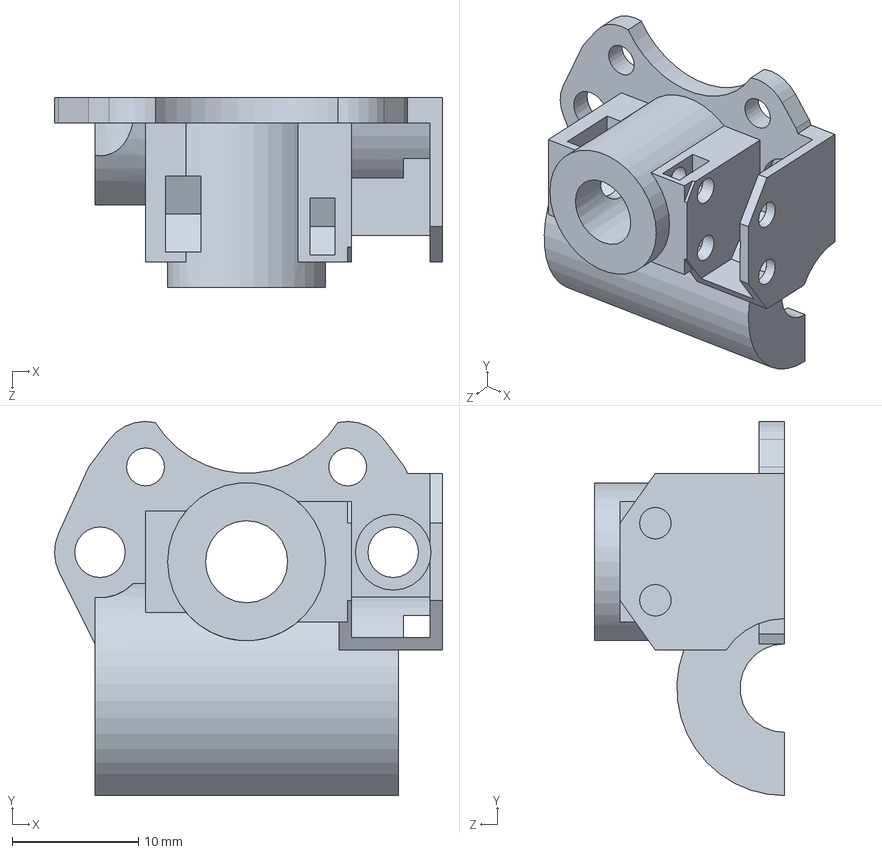
[picture p60: CAD file, 2016-01-19]
CAD/Solidworks/Y-Carriage Left w. Stepper and Endstop.SLDPRT
30.7 x 29.6 x 15.0 mm
