OpenLabTools/Microscope/CAD/Solidworks/8mm x 120mm Threaded Rod.SLDPRT

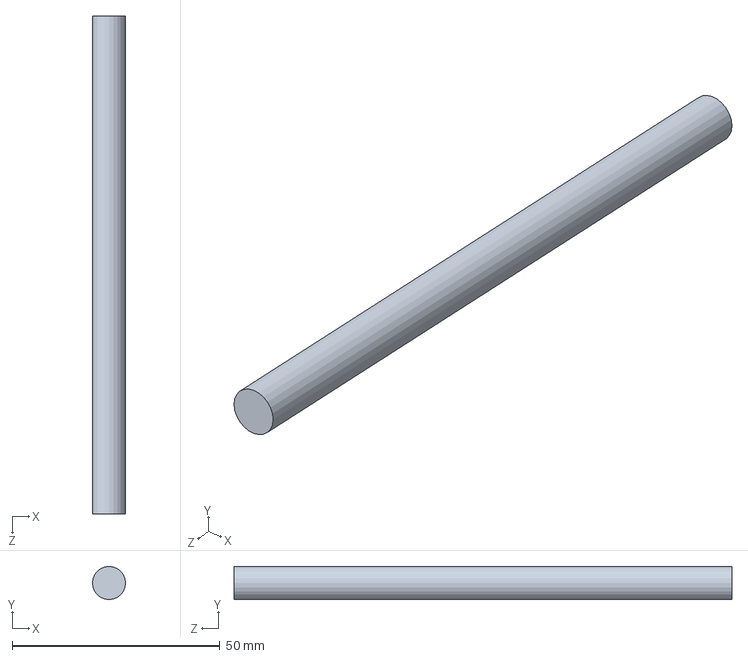
[picture p61: CAD file, 2016-01-19]
CAD/Solidworks/8mm x 120mm Threaded Rod.SLDPRT
8.00 x 8.00 x 120.0 mm
