OpenLabTools/Microscope/CAD/Solidworks/NEMA 8 Small Stepper Motor.SLDPRT

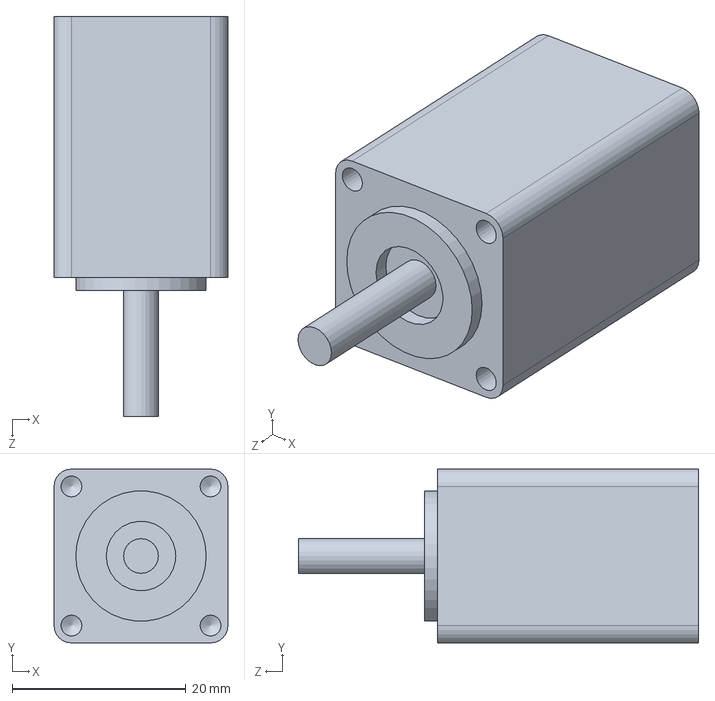
[picture p62: CAD file, 2016-01-19]
CAD/Solidworks/NEMA 8 Small Stepper Motor.SLDPRT
20.0 x 20.0 x 46.0 mm
