OpenLabTools/Microscope/CAD/Solidworks/Flex Shaft Coupler.SLDPRT

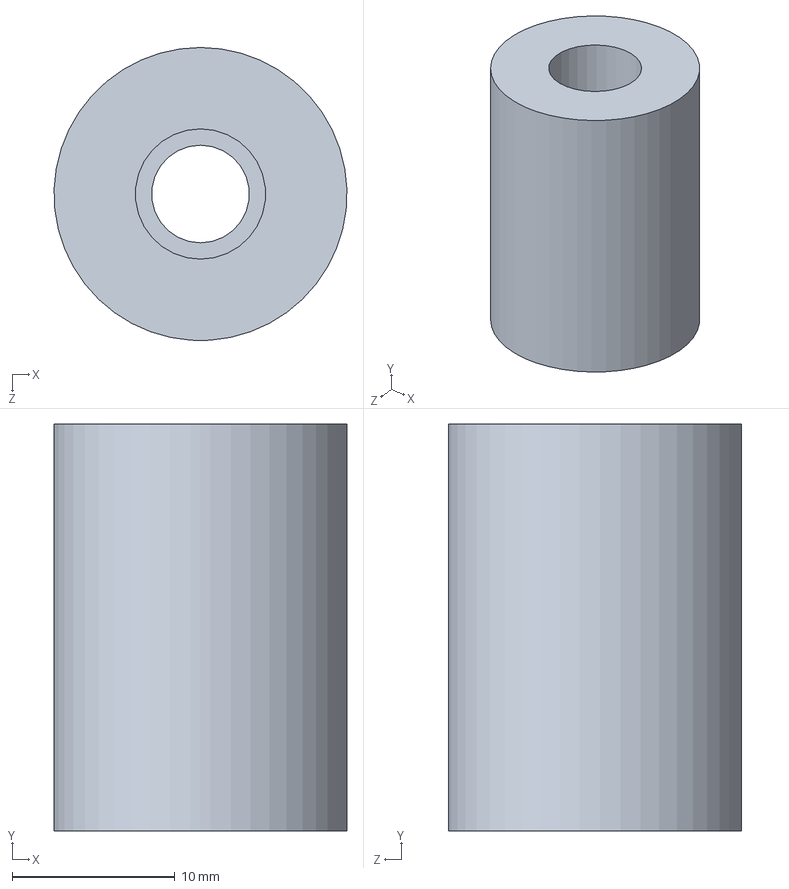
[picture p63: CAD file, 2016-01-19]
CAD/Solidworks/Flex Shaft Coupler.SLDPRT
18.0 x 25.0 x 18.0 mm
