OpenLabTools/Microscope/CAD/Solidworks/X-Carriage Single Bearing.SLDPRT

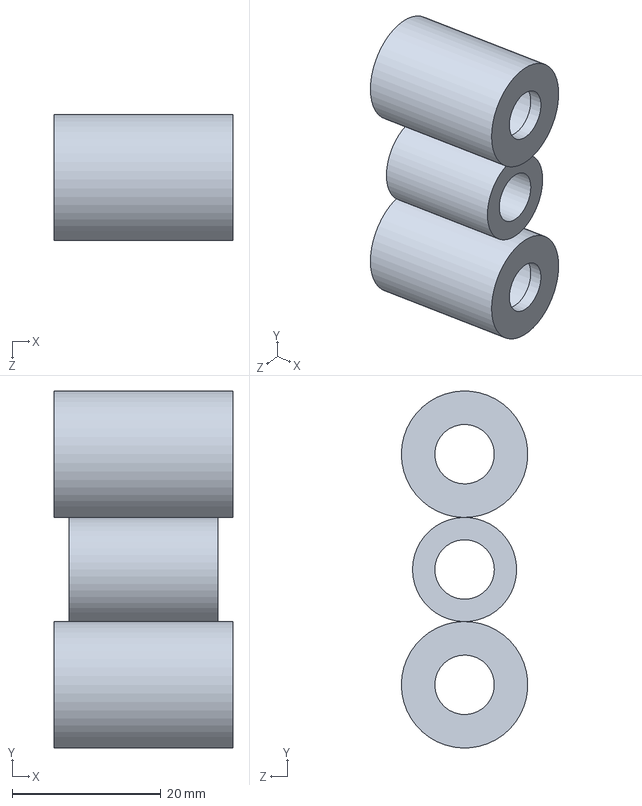
[picture p64: CAD file, 2016-01-19]
CAD/Solidworks/X-Carriage Single Bearing.SLDPRT
24.0 x 48.0 x 17.0 mm
