OpenLabTools/Microscope/CAD/Solidworks/Bearing Mount Left Bottom.SLDPRT

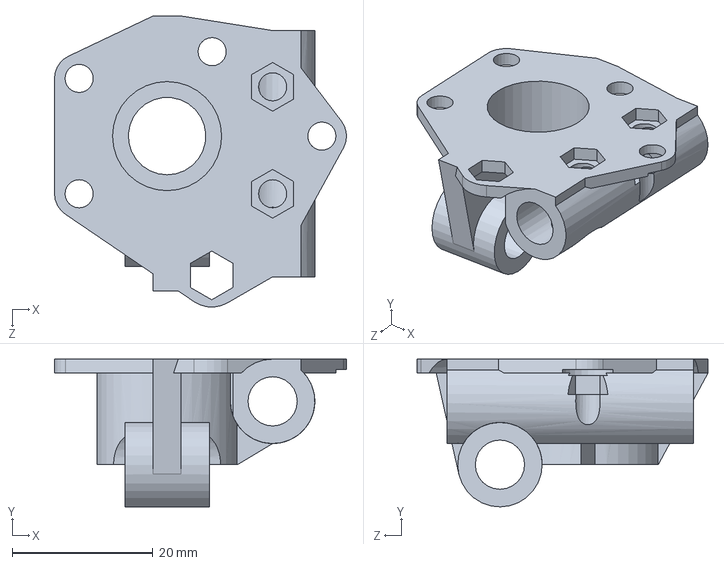
[picture p65: CAD file, 2016-01-19]
CAD/Solidworks/Bearing Mount Left Bottom.SLDPRT
41.5 x 21.0 x 41.4 mm
