OpenLabTools/Microscope/CAD/Solidworks/X-Carriage.sldprt

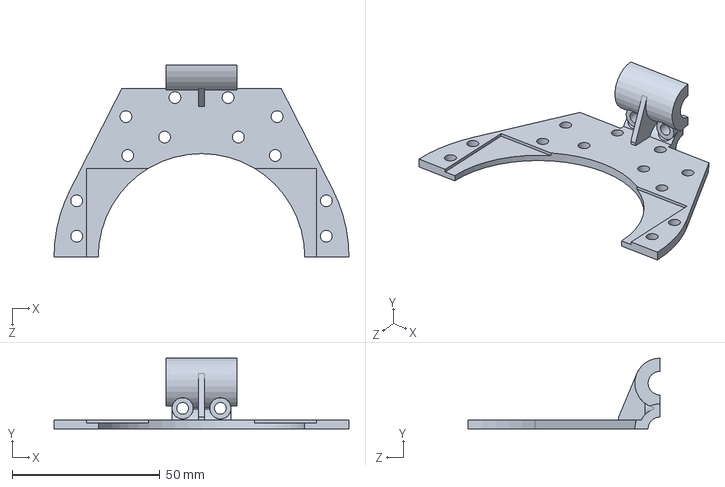
[picture p66: CAD file, 2016-01-19]
CAD/Solidworks/X-Carriage.sldprt
100.0 x 24.0 x 65.0 mm
