OpenLabTools/Microscope/CAD/Solidworks/Stepper Motor NEMA 17.SLDPRT

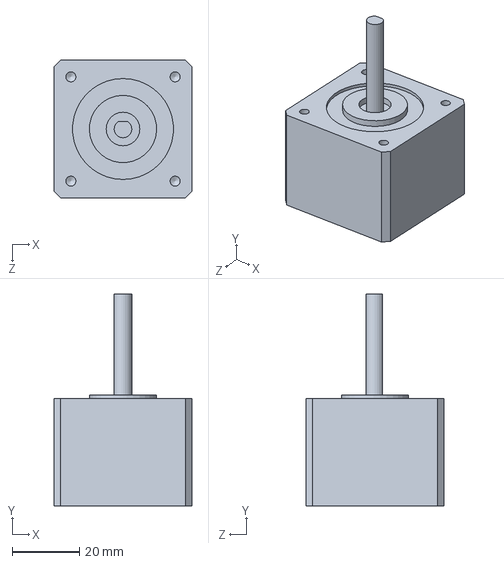
[picture p67: CAD file, 2016-01-19]
CAD/Solidworks/Stepper Motor NEMA 17.SLDPRT
41.0 x 63.0 x 41.0 mm
