OpenLabTools/Microscope/CAD/Solidworks/Shaft Coupler 4mm-6mm.SLDPRT

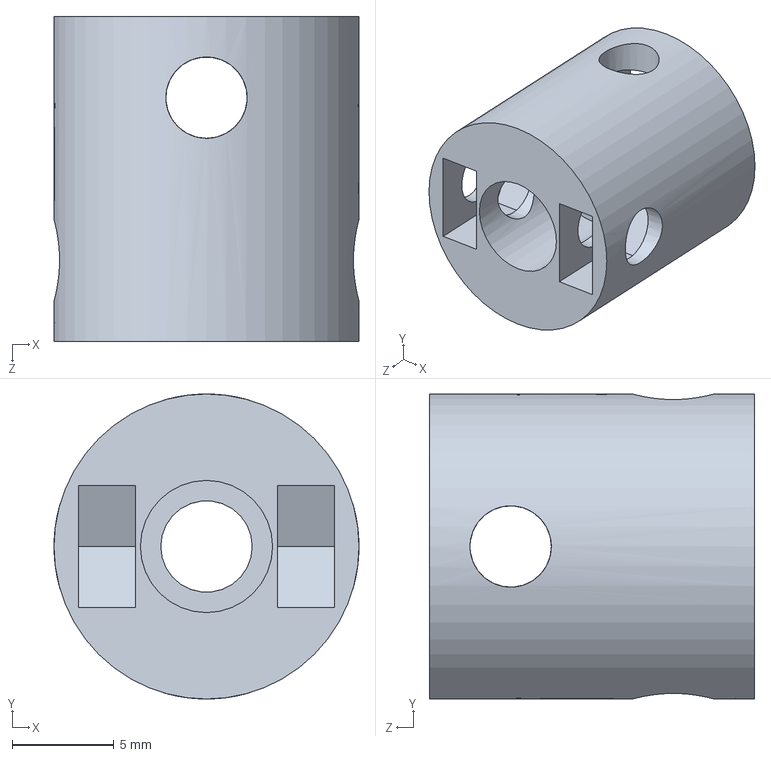
[picture p68: CAD file, 2016-01-19]
CAD/Solidworks/Shaft Coupler 4mm-6mm.SLDPRT
15.0 x 15.0 x 16.0 mm
