OpenLabTools/Microscope/CAD/Solidworks/Z Stage End Right w. Endstop.SLDPRT

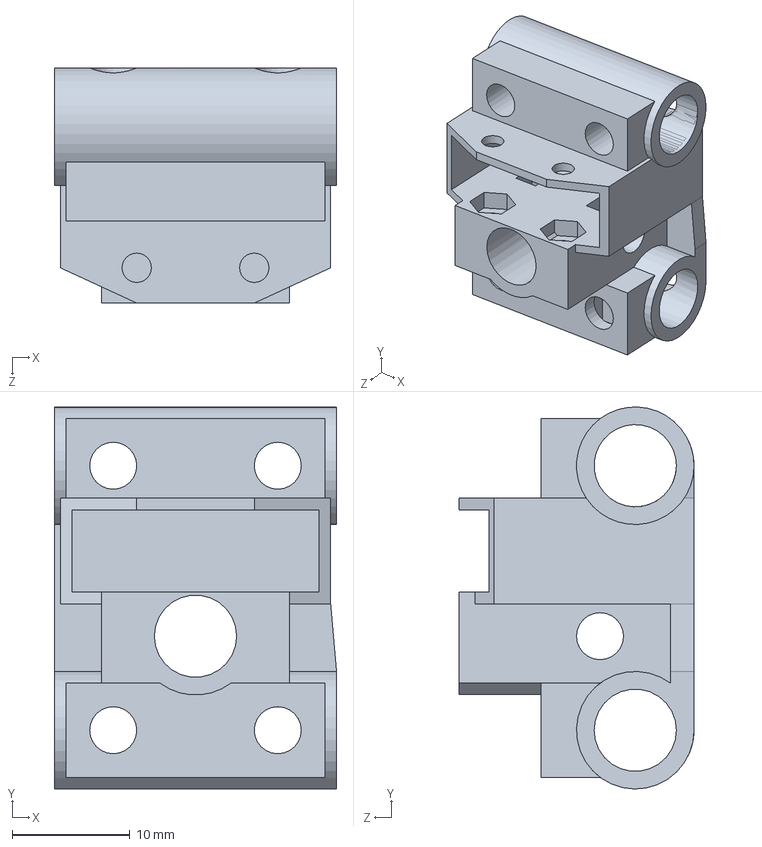
[picture p69: CAD file, 2016-01-19]
CAD/Solidworks/Z Stage End Right w. Endstop.SLDPRT
24.0 x 32.5 x 20.0 mm
