OpenLabTools/Microscope/CAD/Solidworks/Y-Carriage Right w. Endstop.SLDPRT

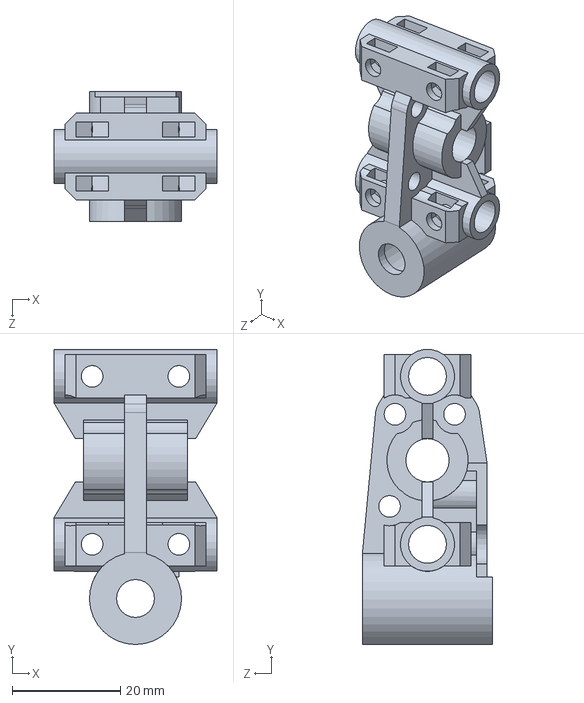
[picture p70: CAD file, 2016-01-19]
CAD/Solidworks/Y-Carriage Right w. Endstop.SLDPRT
30.0 x 54.5 x 24.0 mm
