OpenLabTools/Microscope/(list of files, cad)

Other CAD files:
CAD/Solidworks/Optics Clamp Mk2.SLDPRT
CAD/Solidworks/Bearing Mount Right Bottom.SLDPRT
CAD/Solidworks/Bearing Mount Left.SLDPRT
CAD/Solidworks/Bearing Mount Right Top.SLDPRT
CAD/Solidworks/Y-Carriage Left.sldprt
CAD/Bearing Mount Left Bottom.STL
CAD/Bearing Mount Left Top.STL
CAD/Bearing Mount Right Bottom.STL
CAD/BearingMountRightTop.stl
CAD/Endstop Mount.STL
CAD/Front Stage Mount.STL
CAD/Lighting Mount.STL
CAD/M3 Spacer.STL
CAD/Pi Camera Mount.STL
CAD/Solidworks/Thread Nut Mount Crossbeams Bottom.SLDPRT
CAD/Solidworks/Thread Nut Mount Crossbeams Top.SLDPRT
CAD/Solidworks/Thread Nut Mount Crossbeams.SLDPRT
CAD/Solidworks/Thread Nut Mount.SLDPRT
CAD/Stage Protector.STL
CAD/Thread Nut Mount Bottom.STL
CAD/Thread Nut Mount Top.STL
