OpenLabTools/Microscope/Raspberry Pi/CPP/programming_tutorial_2.pdf

# Automation Tutorial 2: Code Description

## Marco Selvi

## 8th September 2013

# Aims

In this tutorial we will describe in more details what the code written for the microscope’s automation actually does. All programs have been written in C++, with the use of different libraries for image processing and serial port communication. In the next section we list all packages and libraries necessary

for the correct compilation and execution of the programs themselves.

Remember however that, while this program will compile and run on any platform, it is meant to work on the Raspberry Pi. This is in particular obvious from the restriction for image capture using the program RaspiStill, available only on the Pi. If run on any other platform that does not have RaspiStill as a

program, the routine will run correctly until the first invocation of ’raspistill’, and then crash.

# Libraries and Packages

Here we list all packages necessary for the correct execution of the program,

### with a short description for each. Terminal commands for obtaining all packages

are at the end of this section.

## Imaging: CoolImage Library

### For the programs that follow we will use the Cool Image Library, obtainable

from this website. (http://cimg.sourceforge.net/) This is a template library, contained all in one header file. It

### is very easy to use and efficient at run-time, but takes quite a while to compile

on the Raspberry Pi (it contains approximately 45,000 lines of code). To use it,

### simply include the ”CImg.h” file downloadable from the website in the heading of your code and it will work at compile time. See any example of programs in

the next sections to check where to include it.

We suggest creating a dummy .cpp file containing the library itself and the definition of the components used, so that it can be compiled separately and then linked as an object. A header file of similar type might be useful also. We have not considered this possibility until the writing of this tutorial because software development was done on a computer that could handle compilation of the CImg.h file easily, but if you plan to do software development on the Pi this is definitely an

option to explore.

1

## Serial Communication: Boost Asio Library

### Communication over the serial port is done using the Boost Asio library (see

here (http://www.boost.org/doc/libs/1_54_0/doc/html/boost_asio.html) for documentation). This library provides rather simple to implement (if

### hard to devise) communication with the Arduino. Opening a serial port with this library allows the user to use the serial communication as a stream not dis-similar from the ’iostream’ available from the C++ inbuilt libraries. Commands

can be written to the stream and outputs can be read from it. However...

A NOTE of caution: the non-asynchronous functions used to read from the serial port block until the buffer used to read into is full (so they must read at least one character, if the buffer used if of such size). If you are developing your own software using this library, be sure that whenever a ’read’ function is

called on the serial port stream there will be some output to read. Otherwise,

### your program will block forever. Alternatively, try using the asynchronous read

functions provided in the boost libraries. If you can figure out how.

## Terminal Commands to Install Libraries

### You will need the ’imagemagick’ package to handle window display from the

CoolImage library through the ’CImgDisplay’ class.
You will also need to make sure that the X11 video libraries are installed. These are generally already installed in Raspbian, but checking can’t hurt.

### As we said, the CoolImage library is used by simply including the header

file, so no package is installed for it.

### Just to be on the safe side, or if you want to do some testing, you may install

the Python imaging library as well. It is not as efficient as the CoolImage library,

### so since our programs are rather speed-sensitive we opted for the latter, but it

is a good first-stage development tool.

### So the commands to use to install everything are

### sudo apt-get update sudo apt-get install libx11-dev imagemagick python-imaging libboost-all-dev

And you are done installing stuff. Now for the real programming...

# Edge Recognition

Here we report an implementation of the Canny Edge Recognition algorithm (http://en.wikipedia.org/wiki/Canny_edge_detector)

### as an example of how to do image processing with the CoolImage library. The

relevant code files are found here. (https://github.com/OpenLabTools/Microscope/tree/master/Raspberry%20Pi)

### As it can be seen from a quick analysis, the ’edges.cpp’ file is a very basic user interface, while all the computation is done in the header file ‘edgedetection class.h’. We will therefore skip a detailed analysis of the former, and

concentrate on what the latter does.

## edgedetection class.h

### This file handles all the processes needed to detect edges in an image using the Canny Edge Detection algorithm mentioned above. We use ‘.jpg’ files because they have only one layer and are therefore more easily analysed. The

2

### CoolImage library can of course work with multi-layer images such as ‘.bmp’ as well, but the code will need heavy remodeling to work with more complex images. To make your life easier, just convert images to ‘.jpg’. Edges don’t need

multi-layering anyway.

The file ‘edgedetection class.h’ (as the name suggests) containes a class whose methods do everything in the edge detection algorithm. The method in-voked by ‘edges.cpp’ is ‘canny edge detection()’ that takes no arguments. This method then invokes all other methods in the class. Check all other methods in the complete header file at the link mentioned above. We don’t report them

here to avoid clutter.

### This is the code for the principal method, with relevant comments. The

comments should be self explanatory.

194 | CImg<float> Edgedetection::canny edge detection()
195 | {

196
197 | // First we show the picture we start with
198 | m show.display(m picture);

199

200
201 | // Load convolution matrix for noise damping
202 | // This matrix will be convolved with the image to smooth away artifacts and ’ruined’
| pixels
203 | load matrix();
204 | cout << ”\nFinished loading convolution matrix for noise filtering ” << endl;

205

206

207
208 | // Reduce image to greyscale (intensity scale)
209 | // This is necessary for the following analysis , since we are interested in the
| intensity of the pixels and not their colour
210 | //if ((m picture(0,0,0,0) != m picture(0,0,0,1)) || (m picture(0,0,0,0) != m picture
| (0,0,0,2)))
211 | //{
212 | greyfy() ;
213 | cout << ”\nFinished turning image to greyscale” << endl;
214 | //}
215 | //else
216 | // cout << ”\nImage is already in greyscale” << endl;

217
218 | // Display the image after turning to grayscale
219 | m show.display(m picture);

220

221

222
223 | // Apply convolution with preset matrix
224 | picture convolution () ;

225
226 m show.display(m picture);

227
228 cout << ”\nFinished noise filtering” << endl;

229

230

231
232 | // Calculate gradients associated with each pixel
233 | // Refer to the ’Canny Edge Detector’ article on Wikipedia to know why this is
| necessary
234 | // Here we have implemented two possibilities for the gradient calculation
235 | // See the specific methods within the class for further details
236 | //simple gradient();

3

237 sobel gradient () ;

238
239 cout << ”\nFinished calculating gradient for the pixels” << endl;

240

241

242
243 | // Decide whether each pixel is on the edge or not
244 | // This is done following the Canny Edge Detection method of minor and major edges
245 | // See method for details
246 | edge decision () ;

247
248 | // Assign different grey tonalities to major edges, minor edges and non−edges
| respectively
249 | for (int i=0; i<m picture.width(); i++) {
250 | for (int j=0; j<m picture.height(); j++)
251 | {

252
253 | if (m edge[i][ j ] == 2)
254 | {
255 | m picture(i, j ,0,0) = 255;
256 | m picture(i, j ,0,1) = 255;
257 | m picture(i, j ,0,2) = 255;
258 | }
259 | else if (m edge[i][ j ] == 1)
260 | {
261 | m picture(i, j ,0,0) = 130;
262 | m picture(i, j ,0,1) = 130;
263 | m picture(i, j ,0,2) = 130;
264 | }
265 | else
266 | {
267 | m picture(i, j ,0,0) = 0;
268 | m picture(i, j ,0,1) = 0;
269 | m picture(i, j ,0,2) = 0;
270 | }

271
272 | }
273 | }

274
275 | // Display edges
276 | m show.display(m picture);

277
278 cout << ”\nFinished establishing edges” << endl;

279
280 m show.wait(2000);

281

282

283
284 | // Select edges that are REAL edges
285 | // This is done by checking proximity of minor edges with major edges, or by continuing
| major edges into minor edges if they are reciprocal continuation
286 | // See method for details
287 | edge selection () ;

288
289 | // Assign ’white’ to real edges, and black to non−edges
290 | for (int i=0; i<m picture.width(); i++) {
291 | for (int j=0; j<m picture.height(); j++)
292 | {

293
294 | if (m edge[i][ j ] == 2)
295 | {
296 | m picture(i, j ,0,0) = 255;

4

297 | m picture(i, j ,0,1) = 255;
298 | m picture(i, j ,0,2) = 255;
299 | }
300 | else
301 | {
302 | m picture(i, j ,0,0) = 0;
303 | m picture(i, j ,0,1) = 0;
304 | m picture(i, j ,0,2) = 0;
305 | }

306
307 | }
308 | }

309
310 | // Display final result
311 | m show.display(m picture);

312
313 cout << ”\nFinished selecting edges” << endl << endl;

314
315 | // Save final result if so required by the user, cropping away the black fringes that
| result from the edge detection work
316 | if (m save == ’y’)
317 | {
318 | crop and save();
319 | m show.wait(2000);
320 | }
321 | else
322 | m show.wait();

323
324 | // Return the picture result , in case one may want to do more with it (we don’t here,
| but you never know)
325 | return m picture;

326
327 }

### edgedetection class.h

# Microscope Control

Now we can start tackling more complex tasks, useful for the control of the microscope. In particular, we need to make all functions and methods ‘cooper-ate’ efficiently and as fast as possible. The algorithm used in this program is available in the Tutorial 1 PDF. Here we analyse the methods used in the steps

of the algorithm.

## Image Acquisition

### To acquire images to be used in the focusing algorithm, we use the inbuilt ‘raspistill’ program available with the Raspberry Pi camera libraries. To do so, we simply call a ‘system()’ function, which allows to call terminal programs

from within a C++ program.

1 | system(” raspistill −n −w 480 −h 360 −o test.jpg”);

2

5

## Image Analysis

### We use the CImg library to open the images, and the use the focusing formula

contained in this method to analyse them.

472 | float Autofocus::algorithm()
473 | {

474
475 | float intensity = 0.0;
476 | float mean intensity = 0.0;
477 | float intensity squared sum = 0.0;
478 | float focusing = 0.0;

479
480 greyfy() ;

481
482 | // Calculate intensity of a matrix of pixels
483 | for (int x=0; x<m picture.width(); x++) {
484 | for (int y=0; y<m picture.height(); y++)
485 | {
486 | intensity += (float)(m picture(x,y,0,0));
487 | }
488 | }

489
490 mean intensity = intensity/(float)(m picture.width()∗m picture.height());

491
492 | // Make sure that no value of mean intensity is effectively 0.0
493 | // to prevent division by 0, even though very unlikely
494 | if (mean intensity == 0.0) mean intensity = 1E−10;

495
496 | // Apply focusing algorithm of choice, in this case a normalised deviation based
497 | for (int i=0; i<m picture.width(); i++) {
498 | for (int j=0; j<m picture.height(); j++)
499 | {
500 | intensity squared sum += ((float)m picture(i,j,0,0) − mean intensity)∗((float)
| m picture(i, j ,0,0) − mean intensity);
501 | }
502 | }

503
504 | focusing = intensity squared sum/((float)m picture.width()∗(float)m picture.height()∗
| mean intensity);

505
506 return focusing;

507
508 }

### autofocus class.h

### This is used to compute a focusing value for each picture taken with ‘raspistill’. Then the program uses these values in the previous algorithm to decide

what to do.

## Arduino Control

To control the Arduino, we use the following method.

1150 bool Autofocus::serial command(string command, int &number, bool couting, string check )

1151 | {
1152 | stringstream ss ;
1153 | istream is (&m buffering);
1154 | string line ;
1155 | bool control = false;

6

1156 bool exiting = false;

1157

1158
1159 | if (command.compare(m calibrate) == 0)
1160 | {
1161 | ss << command;
1162 | write(m sp, buffer(ss . str ()));
1163 | ss . str (””);

1164
1165 | return true;
1166 | }
1167 | else if (command.compare(m is cal) == 0)
1168 | {
1169 | ss << command;
1170 | write(m sp, buffer(ss . str ()));
1171 | ss . str (””);

1172
1173 | while (exiting == false)
1174 | {
1175 | boost:: asio :: read until (m sp, m buffering, ’\n’);
1176 | getline ( is , line );
1177 | if (couting)
1178 | cout << line << endl;
1179 | if (atoi ( line . c str ()) != 0)
1180 | control = true;
1181 | if ( line .compare(check) == 0)
1182 | exiting = true;

1183
1184 | line . clear () ;
1185 | }
1186 | }
1187 | else if (command.compare(m get z distance) == 0)
1188 | {
1189 | ss << command;
1190 | write(m sp, buffer(ss . str ()));
1191 | ss . str (””);

1192
1193 | check = m endpoint;

1194
1195 | for (int i=0; i<3; i++)
1196 | {
1197 | boost:: asio :: read until (m sp, m buffering, ’\n’);
1198 | getline ( is , line );
1199 | if (couting)
1200 | cout << line << endl;
1201 | if ( line .compare(check) == 0)
1202 | control = true;

1203
1204 | line . clear () ;
1205 | }
1206 | }
1207 | // Requires unsigned integer as argument
1208 | else if (command.compare(m move to) == 0)
1209 | {
1210 | string number in words = boost::lexical cast<string>((int)(number));
1211 | ss << command << ” ” << number in words << ”\n”;
1212 | write(m sp, buffer(ss . str ()));
1213 | ss . str (””);

1214
1215 | while (exiting == false)
1216 | {
1217 | boost:: asio :: read until (m sp, m buffering, ’\n’);

7

1218 | getline ( is , line );
1219 | if (couting)
1220 | cout << line << endl;
1221 | if ( line .compare(check) == 0)
1222 | {
1223 | exiting = true;
1224 | control = true;
1225 | }

1226
1227 | if ( line .compare(”ERR: UNKNOWN COMMAND\r”) == 0)
1228 | {
1229 | exiting = true;
1230 | }
1231 | if ( line .compare(”ERR: NOT CALIBRATED\r”) == 0)
1232 | {
1233 | exiting = true;
1234 | }
1235 | if ( line .compare(”ERR: POSITION OUT OF RANGE\r”) == 0)
1236 | {
1237 | exiting = true;
1238 | }

1239
1240 | line . clear () ;
1241 | }
1242 | }
1243 | // Requires signed integer as argument
1244 | else if (command.compare(m move) == 0)
1245 | {
1246 | string number in words = boost::lexical cast<string>((int)(number));
1247 | ss << command << ” ” << number in words << ”\n”;
1248 | write(m sp, buffer(ss . str ()));
1249 | ss . str (””);

1250
1251 | while (exiting == false)
1252 | {
1253 | boost:: asio :: read until (m sp, m buffering, ’\n’);
1254 | getline ( is , line );
1255 | if (couting)
1256 | cout << line << endl;
1257 | if ( line .compare(check) == 0)
1258 | {
1259 | exiting = true;
1260 | control = true;
1261 | }

1262
1263 | if ( line .compare(”ERR: UNKNOWN COMMAND\r”) == 0)
1264 | {
1265 | exiting = true;
1266 | }
1267 | if ( line .compare(”ERR: NOT CALIBRATED\r”) == 0)
1268 | {
1269 | exiting = true;
1270 | }
1271 | if ( line .compare(”ERR: POSITION OUT OF RANGE\r”) == 0)
1272 | {
1273 | exiting = true;
1274 | }

1275
1276 | line . clear () ;
1277 | }
1278 | }
1279 | // Requires a number between 0 and 255 as argument

8

1280 | else if (command.compare(m set stage led bright) == 0 || command.compare(
| m set ring bright) == 0)
1281 | {
1282 | if (number < 0 || number > 255)
1283 | number = 70;

1284
1285 | string number in words = boost::lexical cast<string>((int)(number));
1286 | ss << command << ” ” << number in words << ”\n”;
1287 | write(m sp, buffer(ss . str ()));
1288 | ss . str (””);

1289
1290 | while (exiting == false)
1291 | {
1292 | boost:: asio :: read until (m sp, m buffering, ’\n’);
1293 | getline ( is , line );
1294 | if (couting)
1295 | cout << line << endl;
1296 | if ( line .compare(check) == 0)
1297 | {
1298 | exiting = true;
1299 | control = true;
1300 | }

1301
1302 | if ( line .compare(”ERR: UNKNOWN COMMAND\r”) == 0)
1303 | {
1304 | exiting = true;
1305 | }
1306 | if ( line .compare(”ERR: NOT CALIBRATED\r”) == 0)
1307 | {
1308 | exiting = true;
1309 | }
1310 | if ( line .compare(”ERR: POSITION OUT OF RANGE\r”) == 0)
1311 | {
1312 | exiting = true;
1313 | }

1314
1315 | line . clear () ;
1316 | }
1317 | }
1318 | else
1319 | {
1320 | ss << command;
1321 | write(m sp, buffer(ss . str ()));
1322 | ss . str (””);

1323
1324 | while (exiting == false)
1325 | {
1326 | boost:: asio :: read until (m sp, m buffering, ’\n’);
1327 | getline ( is , line );
1328 | if (couting)
1329 | cout << line << endl;
1330 | if (atoi ( line . c str ()) != 0)
1331 | number = atoi(line.c str ());
1332 | if ( line .compare(check) == 0)
1333 | {
1334 | exiting = true;
1335 | control = true;
1336 | }

1337
1338 | if ( line .compare(”ERR: UNKNOWN COMMAND\r”) == 0)
1339 | {
1340 | exiting = true;

9

1341 | }
1342 | if ( line .compare(”ERR: NOT CALIBRATED\r”) == 0)
1343 | {
1344 | exiting = true;
1345 | }
1346 | if ( line .compare(”ERR: POSITION OUT OF RANGE\r”) == 0)
1347 | {
1348 | exiting = true;
1349 | }

1350
1351 | line . clear () ;
1352 | }
1353 | }

1354
1355 | return control;
1356 | }

### autofocus class.h

The commands we pass are prebuilt in the code loaded on the Arduino, available here. (https://github.com/OpenLabTools/Microscope/tree/master/Arduino) What they do is pretty straightforward, and at the link above

a full description of all the commands available is provided. Note that we use the ‘boost::asio::read some()’ and the ‘boost::asio::read until()’ functions to read the output from the Arduino and save it in strings we can use to interpret it. It is important to make sure that every time we read an output, there is an output to read. Otherwise these functions will block. For a complete

documentation of these functions check the links available here. (http://www.boost.org/doc/libs/1_54_0/doc/html/boost_asio/overview/serial_ports.html) Other formulas

### are available for the usage of Arduino controls from the main program. Check the full code for details. They all contain the necessary comments to understand

their functionality.

## Algorithm Implementation

The implementation of the tuning algorithm is in this function.

587 | bool Autofocus::fine tune(float f max, int f max pos,
588 | bool previous direction,
589 | bool up or down,
590 | int times checked)
591 | {

592
593 | float f above = 0;
594 | float f below = 0;
595 | int f above pos = 0;
596 | int f below pos = 0;

597

598
599 | if (! previous direction && m steps > m min steps)
600 | {
601 | //cout << ”\nReducing number of steps... ” << endl;
602 | m steps = (int)(0.5∗m steps);
603 | }
604 | else if (m steps <= m min steps)
605 | {
606 | //cout << ”\nUsing minimum number of steps: ” << m min steps << endl;
607 | m steps = m min steps;
608 | }

609

610
611 // Take picture at starting point

10

612 raspistill save () ;

613

614
615 | // Compute MIDDLE picture
616 | f max = move and capture(0, f max pos);
617 | cout << ”.” << flush;
618 | m values << m ind << ”\t” << f max << endl;
619 | m ind++;

620
621 | // Set max values for future use
622 | m f max = f max;
623 | m f max pos = f max pos;

624
625 | // Remove picture if necessary
626 | if (!m leave output)
627 | remove picture();

628

629
630 //cout << ”\nStart call at\n” << f max pos << ”\t” << f max << endl;

631

632

633
634 | if (up or down)
635 | // Start checking from ABOVE the starting position
636 | {

637
638 | //cout << ”\nChecking UP...” << endl;

639
640 | f above = move and capture(m steps, f above pos);
641 | //cout << f above pos << ”\t” << f above << endl;
642 | cout << ”.” << flush;

643
644 | // Remove picture if necessary
645 | if (!m leave output)
646 | remove picture();

647

648

649
650 | if (f above >= ((2.0−m precision)∗f max))
651 | {

652
653 | //cout << ”\nStaying UP...” << endl;

654
655 | // Keep checking up, maintaining the same number of steps
656 | fine tune (f above, f above pos, true, true);

657
658 | }
659 | else
660 | {

661
662 | //cout << ”\nChecking DOWN...” << endl;

663
664 | f below = move and capture(−2∗m steps, f below pos);
665 | //cout << f below pos << ”\t” << f below << endl;
666 | cout << ”.” << flush;

667
668 | // Remove picture if necessary
669 | if (!m leave output)
670 | remove picture();

671

672

673

11

674 | if (f below >= ((2.0−m precision)∗f max))
675 | {

676
677 | //cout << ”\nStaying DOWN...” << endl;

678
679 | // Change direction of movement and continue checking down
680 | fine tune (f below, f below pos, false, false);

681
682 | }
683 | else
684 | {

685
686 | //cout << ”\nI was already there, so I am going back... ” << times checked <<
| endl;

687
688 | // Move back to maximum
689 | serial command(m move to, f max pos);
690 | stop stage () ;

691
692 | // If the maximum hasn’t changed lately (in the last two checks) then we have
| arrived...
693 | if (times checked == m number of times && m steps > m min steps)
694 | {
695 | m steps = m min steps;
696 | fine tune (f max, f max pos, false, false, ++times checked);
697 | }
698 | else if (times checked < m number of times && m steps > m min steps)
699 | {
700 | fine tune (f max, f max pos, false, false, ++times checked);
701 | }
702 | else
703 | {
704 | return true;
705 | }

706
707 | }

708
709 | }

710
711 | }

712

713

714
715 | else
716 | // Start checking from BELOW the starting position
717 | {

718
719 | //cout << ”\nChecking DOWN...” << endl;

720
721 | f below = move and capture(−m steps, f below pos);
722 | //cout << f below pos << ”\t” << f below << endl;
723 | cout << ”.” << flush;

724
725 | // Remove picture if necessary
726 | if (!m leave output)
727 | remove picture();

728

729
730 | if (f below > ((2.0−m precision)∗f max))
731 | {

732
733 | //cout << ”\nStaying DOWN...” << endl;

12

734
735 | // Keep checking down, maintaining the same number of steps
736 | fine tune (f below, f below pos, true, false);

737
738 | }
739 | else
740 | {

741
742 | //cout << ”\nChecking UP...” << endl;

743
744 | f above = move and capture(2∗m steps, f above pos);
745 | //cout << f above pos << ”\t” << f above << endl;
746 | cout << ”.” << flush;

747
748 | // Remove picture if necessary
749 | if (!m leave output)
750 | remove picture();

751

752
753 | if (f above > ((2.0−m precision)∗f max))
754 | {

755
756 | //cout << ”\nStaying UP...” << endl;

757
758 | // Invert direction and start checking above
759 | fine tune (f above, f above pos, false, true);

760
761 | }
762 | else
763 | {

764
765 | //cout << ”\nI was already there, so I am going back... ” << times checked <<
| endl;

766
767 | // Move back to maximum
768 | serial command(m move to, f max pos);
769 | stop stage () ;

770
771 | // If the maximum hasn’t changed lately (in the last two checks) then we have
| arrived...
772 | if (times checked == m number of times && m steps > m min steps)
773 | {
774 | m steps = m min steps;
775 | fine tune (f max, f max pos, false, true, ++times checked);
776 | }
777 | else if (times checked < m number of times && m steps > m min steps)
778 | {
779 | fine tune (f max, f max pos, false, true, ++times checked);
780 | }
781 | else
782 | {
783 | return true;
784 | }

785
786 | }

787
788 | }

789
790 | }

791
792 return true;

793

13

794 }

### autofocus class.h

### The passages are directly correlated to the algorithm in Tutorial 1. We use a (rather arbitrary) minimum number of steps for each objective, that should give a sufficient resolution to find a focus point while disregarding changes due to

noise. We also use an acceptance threshold (default is 99%) on the focus value,

### to account for noise influence. Code is available for a more automated focusing

program in the file focus everything.h. (https://github.com/OpenLabTools/Microscope/tree/master/Raspberry%20Pi) For more details check the comments on the code provided.

## Other Files

### The file ‘focus everything.h’ implements different usages of the autofocus

class. Again check comments for descriptions.

### The file ‘autofocus class initialisation.h’ contains an implementation of in-structions to initialise the autofocus class. It also provides the possibility to use a default initialisation, that will assume the objective in use on the microscope

is a ‘4x’.

### The file ‘focus everything.cpp’ is the main file that puts together all the header files and provides the user interface through terminal. Through this file it is possible to use all methods provided by the autofocus class recursively, and

decide whether to save the output of each operation.
The ‘Makefile’ provided allows to compile and launch all programs available.

### The flags implemented here are necessary for the correct usage of the boost

libraries and the CImg library, linking all other useful libraries.
All files can be found here, (https://github.com/OpenLabTools/Microscope/tree/master/Raspberry%20Pi) with relevant comments describing all the func-tionalities.

14
