OpenLabTools/Microscope/CAD/Assembly Image.JPG

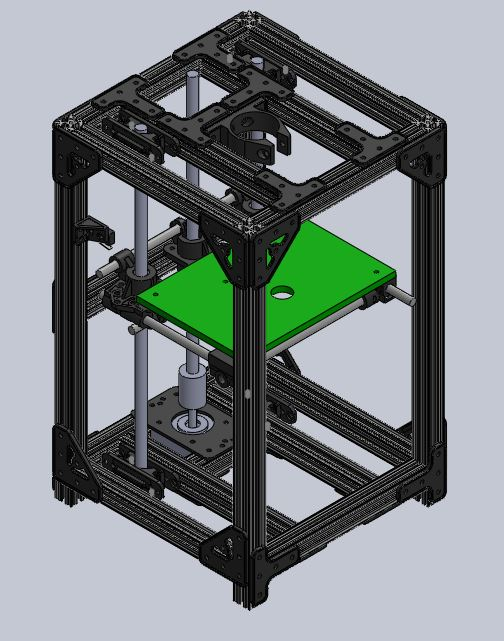
CAD/Assembly Image.JPG
