OpenLabTools/Microscope/Docs/Presentation Images/3D Printing 3.JPG

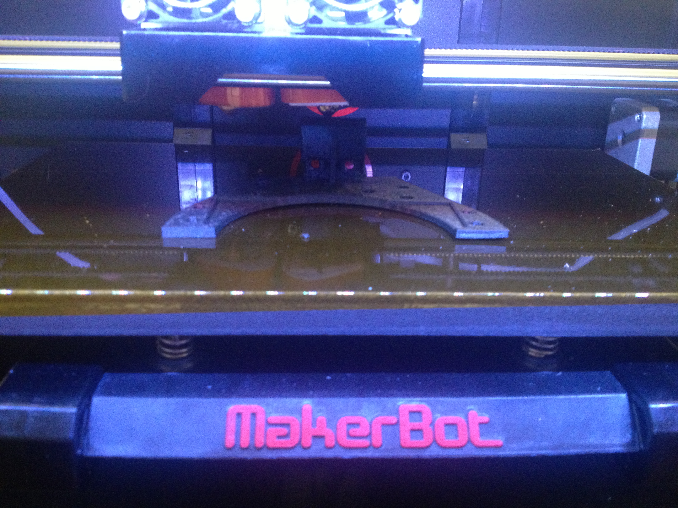
Docs/Presentation Images/3D Printing 3.JPG
