OpenLabTools/Microscope/GUI Test/foobar.bmp

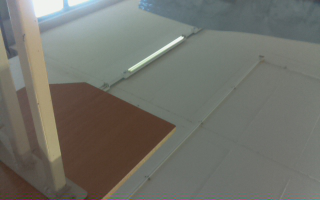
GUI Test/foobar.bmp
