OpenLabTools/Microscope/(threads)

Thread 3 (2015-04-29):

Bearing Mount Right Top.STL

rmcgorty, 2015-04-29:
The files 'Bearing Mount Right Top.STL' and 'Bearing Mount Right Bottom.STL' seem to be identical (and I think both the bottom).

Thread 4 (2016-01-06):

can you upload the CAD files please?

mathewlippincott, 2016-01-06:
Could you please upload 2D or 3D CAD files from the design software you used?
The STL files uploaded are great for replication, but mesh files aren't very useful for modifying parts.

Somahtr, 2016-01-19:
Hi @mathewlippincott. I've managed to track down the original CAD files in SolidWorks format, see 62e07dc827f882cb995bdb6c302bdf92099a08ff. I hope that they are useful!

mathewlippincott, 2016-02-23:
awesome! thank you.

Closed 2016-01-19.

Thread 5 (2016-03-17):

Another open 2-axis motion stage

100ideas, 2016-03-17:
Hi OpenLabTeam,

A while back a built a very DIY-friendly laser-cuttable microscope stage and arduino control app. It used very low-grade servos so the precision was poor, but it worked. I am mentioning it here because I would like to contribute it to the larger OpenLabTools project, if applicable (happy to improve documentation etc if interested).

Here's the repo: https://github.com/100ideas/ucam

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

Thread 7 (2016-12-21):

feedback on documentation

nlooije, 2016-12-21:
I hope you won't take this as negative feedback on an otherwise awesome project but i'd like to use this issue to identify some discrepancies with the documentation.

1. The Bill of Materials in the 'useful information' and 'step-by-step' guide differ for some important materials. Also using the BoM from the step-by-step guide will e.g. not get you enough T-brackets to complete the build.
2. The instructions for the linear stage towards the end of document require more specific instructions. From the text and the pictures it is still too vague how certain parts should be attached. Also is there a template for making holes into the perspex?
3. There is no documentation on the installation of the Arduino and/or RPi software. E.g. several Adafruit libraries are required to be installed. Also no mention is made anywhere of a Touchscreen in the documentation but the Arduino software requires a Touchscreen library. How is this Touchscreen used?

I may append to this list as i find more while i am finishing my build...

JamesRitchie, 2017-01-03:
You're right, the documentation is definitely a problem. I've been intermittently writing some better documentation for the software parts, so I'll see what I can put together, but it's been a few years since I was an undergraduate and working on the project.
