OpenLabTools/Microscope/Arduino/Microscope/SerialControl.h

/*
  SerialControl.h - Library for implementing serial control on the OpenLabTools microscope
  Written by James Ritchie for OpenLabTools
  github.com/OpenLabTools/Microscope
*/
#include "Arduino.h"

#ifndef SerialControl_h
#define SerialControl_h

class SerialControl
{
  public:  
    boolean string_complete;             //Flag to indicate command received
  
    char *input_string; //Raw string from serial
    char *command;
    char *arg; //Argument given with command
  
    int str_pos; //String position counter
  
    SerialControl();
    void begin();
    void serialEvent();
    
  private:  
    void _processString();
};

#endif
