OpenLabTools/Microscope/(commit log)

2013-07-25 Adding Arduino code
2013-07-26 Seperating Serial commands and stage control into classes
2013-07-26 Adding manual control for steppers
2013-07-29 Adding conditional to Stage header
2013-08-02 CAD STEP files added
    [Bearing Mount Left Bottom.STEP, Bearing Mount Left Top.STEP, Bearing Mount Right Bottom.STEP, Bearing Mount Right Top.STEP, Endstop Mount.STEP, Front Stage Mount.STEP, M3 Spacer.STEP, Optics Clamp.STEP]
2013-08-02 Converted CAD to STL format
    (readable in OpenSCad)
    [Assembly All - 6mm x 150mm Threaded Rod-1.STL, Assembly All - 6mm x 150mm Threaded Rod-2.STL, Assembly All - 6mm x 150mm Threaded Rod-3.STL, Assembly All - 6mm x 150mm Threaded Rod-4.STL, Assembly All - 8mm x 120mm Threaded Rod-1.STL, Assembly All - 8mm x 250mm Rod-1.STL, Assembly All - Bearing Mount Left-2.STL, Assembly All - Bearing Mount Right-1.STL]
2013-08-02 Removed Assembly All Components
    Converting an assembly to STL simply saves all its components as STLs,
    but not the overall assembly, so there no extra information in this
    folder
    [Assembly All - 6mm x 150mm Threaded Rod-1.STL, Assembly All - 6mm x 150mm Threaded Rod-2.STL, Assembly All - 6mm x 150mm Threaded Rod-3.STL, Assembly All - 6mm x 150mm Threaded Rod-4.STL, Assembly All - 8mm x 120mm Threaded Rod-1.STL, Assembly All - 8mm x 250mm Rod-1.STL, Assembly All - Bearing Mount Left-2.STL, Assembly All - Bearing Mount Right-1.STL]
2013-08-02 Optics Clamp Updated
    [Optics Clamp.STL]
2013-08-02 Example GUI for the Microscope
    Lighting Panel looks for a serial connection to an arduino and PiGUI
    might struggle to find the test image foobar. Those are the biggest two
    causes for failure. This is just an example of what can easily be done
    with wxPython.
    [GUI_test.py, LightingPanel.py, NotebookDemo.py, PiGUI.py]
2013-08-05 Adding limit switch code and absolute stage positioning
2013-08-05 Optics Clamp Updated + Placeholder added
    [Optics Clamp.STL]
2013-08-07 Adding Arduino Due support
2013-08-09 Updating Arduino readme
2013-08-19 Optical tube Images
2013-08-20 Optical CAD designs
    [25mm_lens_mount.stl, corner_connector.stl, female-female_connector.stl, lighting_mount.stl, male-male_connector.stl, objective_lens_mount.stl]
2013-08-20 Adjustable tube CAD
    [adjustable_length_tube.stl]
2013-08-21 Adding X and Y stage control
2013-08-21 Adding LCD Screen and Rotary Encoder Switch functionality
2013-08-23 Switching to internal pullups on inputs, changing X stepper connection
2013-08-28 Raspberry Pi Camera Datasheet
2013-09-26 Raspberry Pi Code uploaded
2013-10-24 Changing pins to avoid serial conflict on Due
    [Stage.h]
2013-10-24 Changing stage LED to use DAC on Due
2013-10-29 Removing LCD/Rotary encoder code
2013-11-04 Removing Rotary Encoder
2013-11-04 Potential 4-line fix to work with h-bot
    [Stage.cpp]
2013-11-22 Turning stage LED on by default
2014-03-25 Update last frame time
2014-03-25 Hack to fix timeout
    [tracker.py]
2016-01-19 Adding SolidWorks CAD Files
    Added CAD files in the editable SLDPRT format
    [6mm x 150mm Threaded Rod.SLDPRT, 8mm x 120mm Threaded Rod.SLDPRT, 8mm x 250mm Rod.SLDPRT, 8mm x 300mm Smooth Rod.SLDPRT, Assembly All.SLDASM, Bearing Mount Left Bottom.SLDPRT, Bearing Mount Left Top.SLDPRT, Bearing Mount Left.SLDPRT]
2016-12-17 Add files via upload
    True Bearing Mount Right Top (the existing one was just a duplicate of Bearing Mount Right Bottom.
    [BearingMountRightTop.stl]
2016-12-17 Delete wrong Bearing Mount Right Top.STL file
    This was a duplicate of Bearing Mount Right Bottom.STL
    [Bearing Mount Right Top.STL]
